Oopsan204/AML_Micromouse_24_2/AML_MicromousePCB/production/bom.xlsx

Sheet: bom
Designator | Footprint | Quantity | Value | LCSC Part # | mã sp linh kiện chất lượngg | ma sp cxt | stt | Quantity | mã sp linh kiện chất lượngg | ma sp cxt
C1, C10, C14, C2, C20, C22, C27, C28, C29, C3, C4, C5, C7, C8, C9 | 603 | 15 | 100nF |  | CLA4098 |  | 1 | 15 | CLA4098
C11 | 603 | 1 | 1uF |  | CLA4103 |  | 2 | 1 | CLA4103
C12, C13 | 603 | 2 | 2.2uF |  | CLA4104 |  | 3 | 2 | CLA4104
C15 | 603 | 1 | 0.1uF |  | CLA4098 |  | 4 | 1 | CLA4098
C16, C17 | 603 | 2 | 15pF |  | CLA4082 |  | 5 | 2 | CLA4082
C18 | 603 | 1 | 22uF |  | CLA4082 |  | 6 | 1 | CLA4082
C19 | 603 | 1 | 10uF |  | CLA4107 |  | 7 | 1 | CLA4107
C21 | 805 | 1 | 150pF |  | CLA4087 |  | 8 | 1 | CLA4087
C23, C24, C30, C31 | CP_EIA-3216-10_Kemet-I | 4 | 22uF |  | CLA1280 |  | 9 | 4 | CLA1280
C25, C26, C32 | CP_EIA-3216-10_Kemet-I | 3 | 10uF |  | CLA1284 |  | 10 | 3 | CLA1284
C6 | 603 | 1 | 4.7uF |  | CLA4095 |  | 11 | 1 | CLA4095
D1 | D_SMA | 1 | 40V-5A |  |  | A022107 | 12 | 1 |  | A022107
D2, D3, D4, D5, D8, D9 | 603 | 1 | LED |  | CL07448 |  | 13 | 1 | CL07448
I2C, J1, ST-LINK | JST 4 | 3 | Conn_01x04_Socket |  | CLA1870(cái)-CLA1880(đực) |  | 14 | 3 | CLA1870(cái)-CLA1880(đực)
J12 | jst | 1 | Conn_01x02_Socket |  | CLA1878(đực),CLA1868(cái) |  | 15 | 1 | CLA1878(đực),CLA1868(cái)
J5 | PinHeader_1x07_P2.54mm_Vertical | 1 | Conn_01x07_Pin |  | CLA1873(cái),CLA1883(đực) |  | 16 | 1 | CLA1873(cái),CLA1883(đực)
L1 | L_7.3x7.3_H4.5 | 1 | 22uH |  | CLA1397 |  | 17 | 1 | CLA1397
LS1 | CUI_CMT-8530S-SMT | 1 | CMT-8530S-SMT |  |  | A081005 | 18 | 5 |  | A081005
MOTER-R, MOTOR-L | JST 6 | 2 | Conn_01x06_Pin |  | CLA1872(cái),CLA1882(đực) |  | 19 | 2 | CLA1872(cái),CLA1882(đực)
Q1 | SOT-23 | 1 | S8550 |  | CL00852(đã có) |  | 20 | 2 dây | CL00852
R1, R2, R3 | 603 | 3 | 10K |  | CLA0759 |  | 21 | 3 | CLA0759
R10, R11, R19, R20 | 603 | 4 | 1K |  | CLA0742 |  | 22 | 4 | CLA0742
R17, R18 | 603 | 2 | 4.7k |  | CL05810 |  | 23 | 2 | CL05810
R21 | 805 | 1 | 1.1R |  | CLA3613 |  | 24 | 1 | CLA3613
R4 | 603 | 1 | 210K |  |  | G080201 | 25 | 1 |  | G080201
R5 | 805 | 1 | 40.2K |  |  | 04Z3XP | 26 | 1 |  | 04Z3XP
R6, R7 | 603 | 2 | 100k |  | CLA0771 |  | 27 | 2 | CLA0771
R8 | 805 | 1 | 75k |  | CLA3340 |  | 28 | 1 | CLA3340
R9 | 805 | 1 | 20k |  | CLA3326 |  | 29 | 1 | CLA3326
RESET, SW2, SW3 | SW_Tactile_SPST_NO_Straight_CK_PTS636Sx25SMTRLFS | 3 | SW_Push |  | CLA1752 |  | 30 | 3 | CLA1752
RN2, RN3 | R_Array_Convex_5x0603 | 2 | R_Pack05 |  | CL08484 |  | 31 | 2 | CL08484
SW4 | SW_DIP_SPSTx05_Slide_KingTek_DSHP05TS_W7.62mm_P1.27mm | 1 | SW_DIP_x05 |  |  | A022606 | 32 | 1 |  | A022606
U1 | LQFP-100_14x14mm_P0.5mm | 1 | STM32H743VITx |  |  |  | 33 | 1
U2 | SOT-223-3_TabPin2 | 1 | AMS1117 |  | CL00249 |  | 34 | 1 | CL00249
U3 | SOP65P760X160-24N | 1 | TB6612FNG_C_8_EL |  |  |  | 35 | 1
U4 | SO-08POWER | 1 | MP1584 |  |  | A081105 | 36 | 1 |  | A081105
U5 | SOT-223-3_TabPin2 | 1 | AMS1117-5.0 |  | CL00250 |  | 37 | 1 | CL00250
Y1 | Crystal_SMD_3225-4Pin_3.2x2.5mm | 1 | Crystal_GND23_Small |  |  |  | 38 | 1
 |  | 5(dây) |  |  | CLA1877 |  | 39 | 5(dây) | CLA1877

Sheet: lên đơn
stt | sll | đơn vị | Quantity | mã sp linh kiện chất lượngg | ma sp cxt | đon giá | thành giá
1 | 2 | dây | 15 | CLA4098 |  | 2000 | 4000
2 | 1 | dây | 1 | CLA4103 |  | 3000 | 3000
3 | 1 | dây | 2 | CLA4104 |  | 4000 | 4000
4 | 1 | dây | 1 | CLA4098 |  | 2000 | 2000
5 | 1 | dây | 2 | CLA4082 |  | 2000 | 2000
6 | 1 | dây | 1 | CLA4082 |  | 2000 | 2000
7 | 1 | dây | 1 | CLA4107 |  | 3000 | 3000
8 | 1 | dây | 1 | CLA4087 |  | 2000 | 2000
9 | 6 | cái | 4 | CLA1280 |  | 2000 | 12000
10 | 5 | cái | 3 | CLA1284 |  | 1400 | 7000
11 | 1 | dây | 1 | CLA4095 |  | 2000 | 2000
12 | 5 | cái | 1 |  | A022107 | 1500 | 7500
13 | 1 | dây | 1 | CL07448 |  | 2500 | 2500
14 | 1 | túi | 3 | CLA1870(cái)-CLA1880(đực) |  | 3000 | 3000 | mỗi thứ 1 túi
15 | 1 | túi | 1 | CLA1878(đực),CLA1868(cái) |  | 2500 | 2500 | mỗi thứ 1 túi
16 | 1 | túi | 1 | CLA1873(cái),CLA1883(đực) |  | 4500 | 4500 | mỗi thứ 1 túi
17 | 4 | cái | 1 | CLA1397 |  | 1500 | 6000
18 | 5 | cái | 1 |  | A081005 | 6000 | 30000
19 | 1 | túi | 2 | CLA1872(cái),CLA1882(đực) |  | 4500 | 4500 | mỗi thứ 1 túi
20 | 1 | dây | 2 | CL00852 |  | 12000 | 12000
21 | 1 | dây | 3 | CLA0759 |  | 2000 | 2000
22 | 1 | dây | 4 | CLA0742 |  | 2000 | 2000
23 | 1 | dây | 2 | CL05810 |  | 2000 | 2000
24 | 1 | dây | 1 | CLA3613 |  | 3000 | 3000
25 | 1 | dây | 1 |  | G080201 | 1800 | 1800
26 | 1 | dây | 1 |  | 04Z3XP | 2300 | 2300
27 | 1 | dây | 2 | CLA0771 |  | 2000 | 2000
28 | 1 | dây | 1 | CLA3340 |  | 3000 | 3000
29 | 1 | dây | 1 | CLA3326 |  | 3000 | 3000
30 | 1 | dây | 3 | CLA1752 |  | 5000 | 5000
31 | 1 | dây | 2 | CL08484 |  | 4000 | 4000
32 | 1 | cái | 1 |  | A022606 | 7000 | 7000
33 | 1 | dây | 1 |  |  |  | 0
34 | 5 | cái | 1 | CL00249 |  | 1400 | 7000
35 | 3 | cái | 1 |  | A051011 | 30000 | 90000
36 | 2 | cái | 1 |  | A081105 | 10500 | 21000
37 | 5 | cái | 1 | CL00250 |  | 1400 | 7000
38 | 1 | dây | 1 |  |  |  | 0
39 | 3 | dây |  | CLA1877 |  | 1000 | 3000
40 | 2 | cái |  |  | G020804 | 3000 | 6000
41 | 1 | cái |  | CLA2435 |  | 1800 | 1800
 |  |  |  |  |  |  | 0
 |  |  |  |  |  |  | 0
 |  |  |  |  |  |  | 0
 |  |  |  |  |  |  | 0
 |  |  |  |  |  |  | 0
 |  |  |  |  |  |  | 288400
