Oopsan204/AML_Micromouse_24_2/thiet_ke/pcb/schematic.step.SLDASM

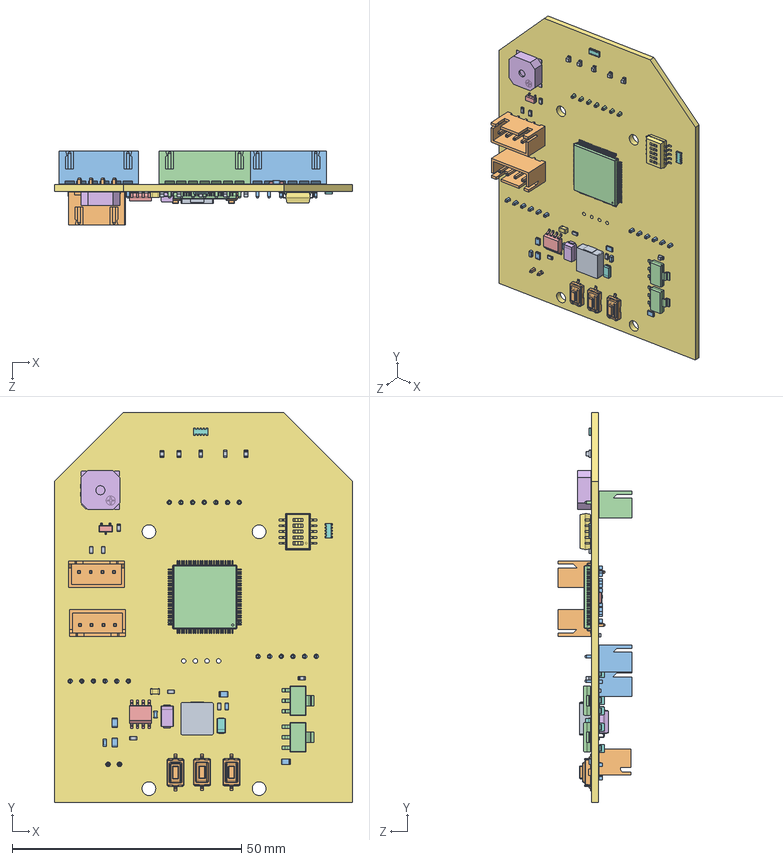
[picture p1: CAD file, 2024-11-29]
thiet_ke/pcb/schematic.step.SLDASM
65.0 x 85.0 x 16.1 mm
LED_0603_1608Metric-0.step x 6
PTS636Sx25SMTRLFS.step x 3
C_0603_1608Metric-1.step x 24
LQFP_100_14x14mm_P05mm.step
SOT_23.step
D_SMA-2.step
C_0805_2012Metric-3.step
R_Array_Convex_5x0603-4.step x 2
R_0603_1608Metric-5.step x 12
JST - XH - Thru - 4Pin - 2.54mm.step x 2
R_0805_2012Metric-6.step x 4
SOT_223.step x 2
ASSEMBLY.step
GSC8530YA-16R2700-7.step
SW_DIP_SPSTx05_Slide_KingTek_DSHP05TS_W762mm_P127mm.step
CP_EIA_3216_10_Kemet_I.step x 7
Inductor_7x7x2.5-8.step
B2B-XH-A(LF)(SN).step
JST - XH - Thru - 6Pin - 2.54mm.step x 2
JST - XH - Thru - 7Pin - 2.54mm.step
Crystal_SMD_3225-4Pin_3.2x2.5mm-9.step
SSOP_24_53x82mm_P065mm.step
schematic_PCB.step
