Oopsan204/AML_Micromouse_24_2/thiet_ke/banh xe 36T.SLDASM

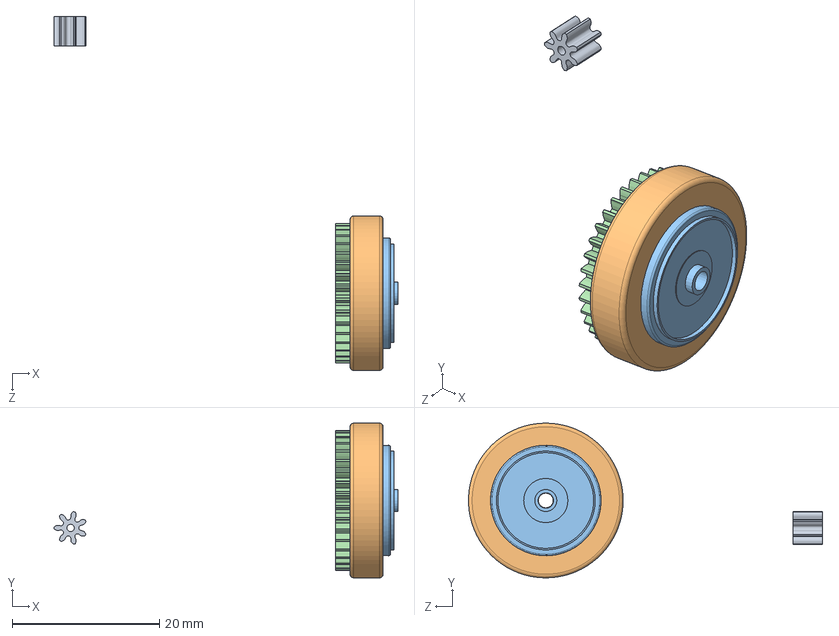
[picture p2: CAD file, 2024-11-29]
thiet_ke/banh xe 36T.SLDASM
46.7 x 21.0 x 48.0 mm
Lop banh xe
Mam banh xe
banh rang 36T truc 2 m0.5.step
banh rang 7T truc1 m0.5
