Oopsan204/AML_Micromouse_24_2/thiet_ke/cumbanh1.SLDASM

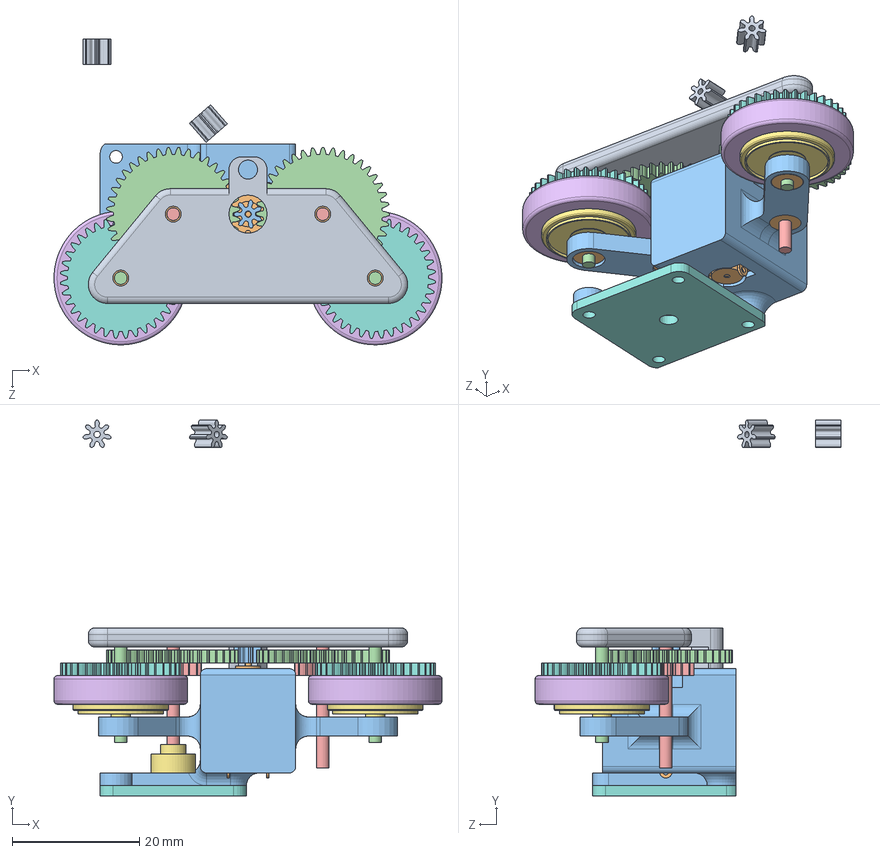
[picture p3: CAD file, 2024-11-29]
thiet_ke/cumbanh1.SLDASM
61.0 x 59.1 x 48.1 mm
N20 DC MOTOR
banh rang 7T truc1 m0.5 x 3
banh rang 40T truc 2 m0.5.step x 2
banh rang 16T truc 2 m0.5.step x 2
Lop banh xe x 2
Mam banh xe x 2
banh rang 36T truc 2 m0.5.step x 2
gangoai
vong bi 2mm x 8
gatrong
truc 2mm 14mm x 2
TRUC 2MM x 2
namcham-encoder
pheutruc
encoder
