Oopsan204/AML_Micromouse_24_2/thiet_ke/cumbanh2.SLDASM

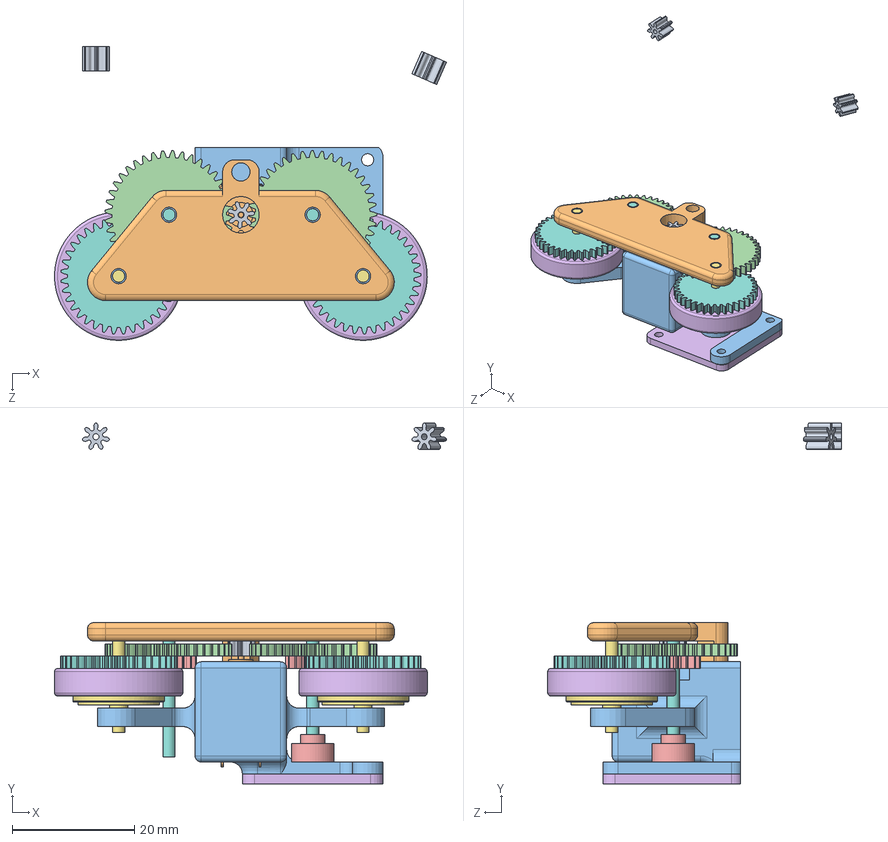
[picture p4: CAD file, 2024-11-29]
thiet_ke/cumbanh2.SLDASM
64.1 x 59.1 x 48.0 mm
N20 DC MOTOR
ga trong 1
banh rang 40T truc 2 m0.5.step x 2
banh rang 16T truc 2 m0.5.step x 2
Lop banh xe x 2
Mam banh xe x 2
banh rang 36T truc 2 m0.5.step x 2
banh rang 7T truc1 m0.5 x 3
gangoai
vong bi 2mm x 8
namcham-encoder
pheutruc
encoder
truc 2mm 14mm x 2
TRUC 2MM x 2
