Oopsan204/AML_Micromouse_24_2/thiet_ke/ver2.5.SLDASM

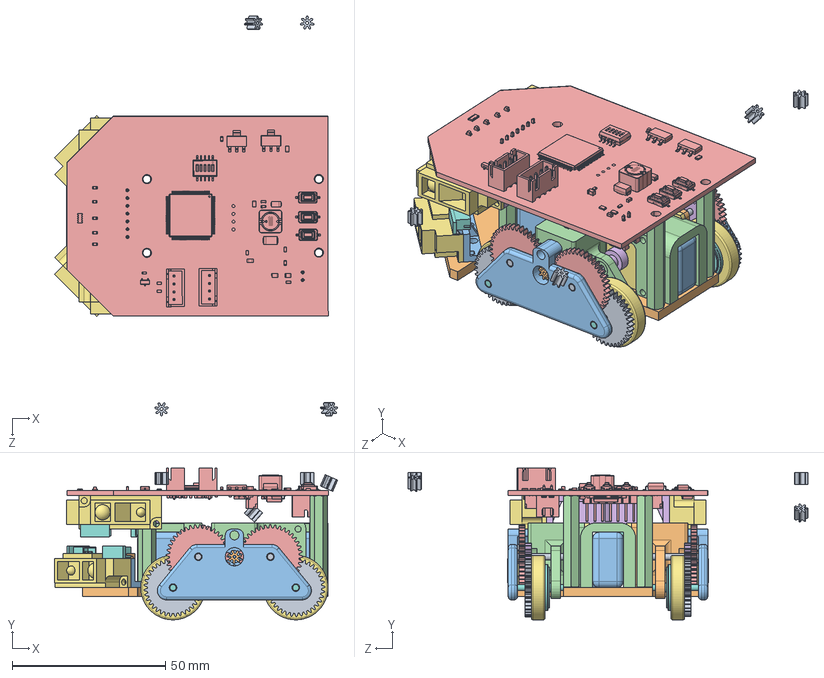
[picture p5: CAD file, 2024-11-29]
thiet_ke/ver2.5.SLDASM
92.3 x 49.4 x 130.3 mm
de mica
N20 DC MOTOR x 2
ga trong 1
banh rang 40T truc 2 m0.5.step x 4
banh rang 16T truc 2 m0.5.step x 4
Lop banh xe x 4
Mam banh xe x 4
banh rang 36T truc 2 m0.5.step x 4
banh rang 7T truc1 m0.5 x 6
gangoai x 2
vong bi 2mm x 16
namcham-encoder x 2
pheutruc x 2
encoder x 2
truc 2mm 14mm x 4
TRUC 2MM x 4
gatrong
pin7.4v 2000mAh 30C
gapin2s x 2
ga cam bien 3
шарп крышка.step x 5
шарп плата.step x 5
92000A010_Passivated 18-8 Stainless Steel Pan Head Phillips Screws.step x 10
ga cam bien don
ga cam bien don trai
truc dong cai cai 30mm x 4
quydo2.step
