Oopsan204/AML_Micromouse_24_2/thiet_ke/banh rang 2 tang 16x40 truc2.SLDASM

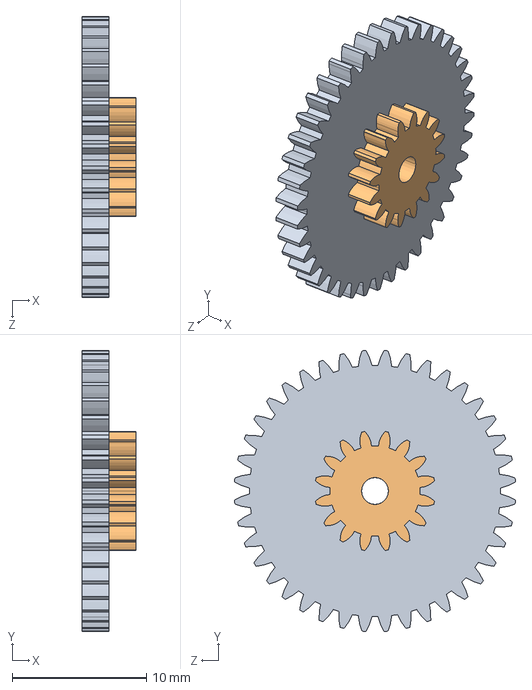
[picture p6: CAD file, 2024-11-29]
thiet_ke/banh rang 2 tang 16x40 truc2.SLDASM
4.00 x 21.0 x 21.0 mm
banh rang 40T truc 2 m0.5.step
banh rang 16T truc 2 m0.5.step
