Oopsan204/AML_Micromouse_24_2/AML_MicromousePCB/3d_modol/GSC8530YA-16R2700.STEP

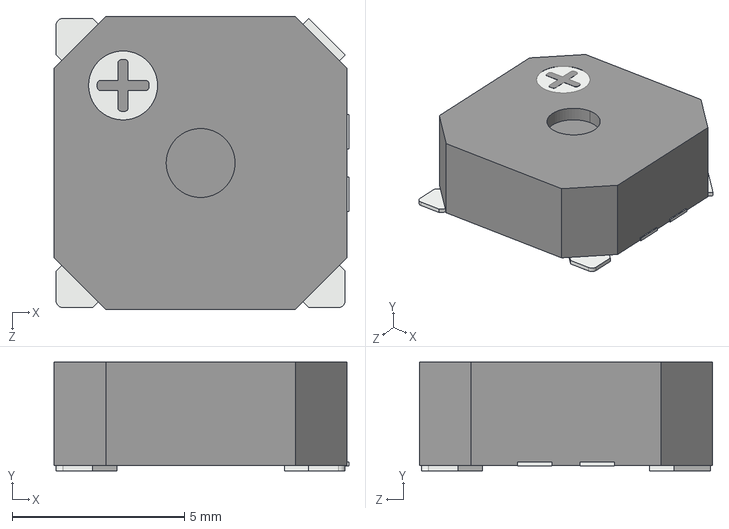
[picture p7: CAD file, 2024-11-29]
AML_MicromousePCB/3d_modol/GSC8530YA-16R2700.STEP
8.55 x 3.15 x 8.50 mm
