Oopsan204/AML_Micromouse_24_2/AML_MicromousePCB/MP1584/MP1584.step

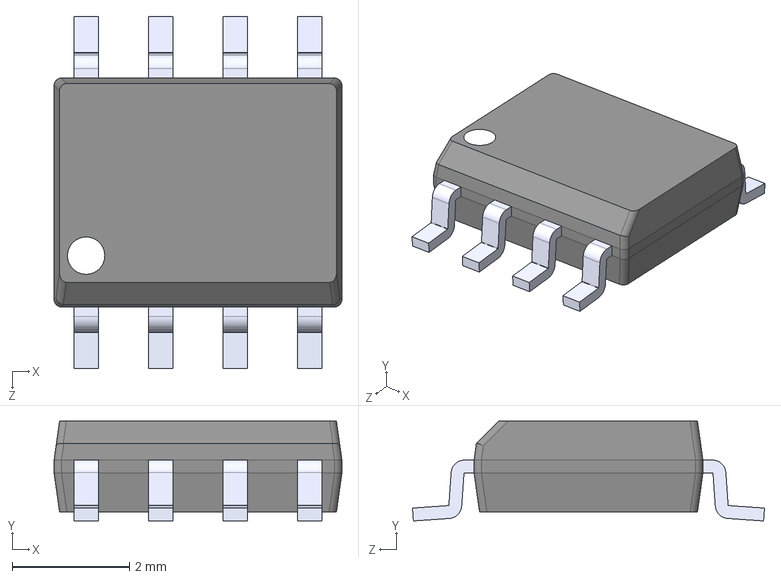
[picture p10: CAD file, 2024-09-05]
AML_MicromousePCB/MP1584/MP1584.step
4.90 x 1.70 x 5.99 mm
