Oopsan204/AML_Micromouse_24_2/AML_MicromousePCB/outline/pcb.DXF

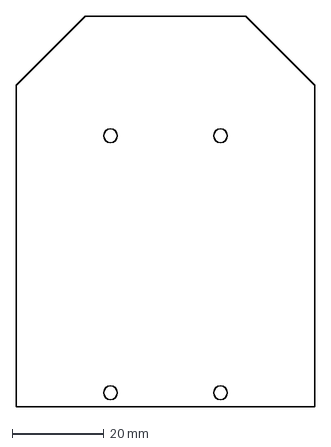
[picture p11: CAD file, 2024-09-10]
AML_MicromousePCB/outline/pcb.DXF
65.0 x 85.0 mm
