Oopsan204/AML_Micromouse_24_2/AML_MicromousePCB/PCB micromouse T2.DXF

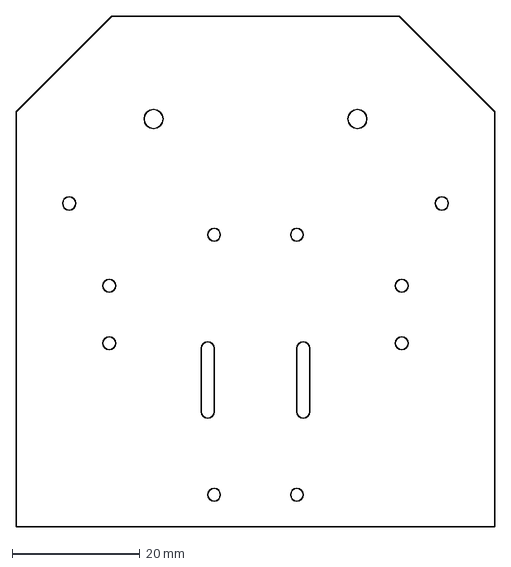
[picture p12: CAD file, 2024-09-10]
AML_MicromousePCB/PCB micromouse T2.DXF
75.0 x 80.0 mm
