Oopsan204/AML_Micromouse_24_2/AML_MicromousePCB/TB6612FNG/TB6612FNG,C,8,EL.STEP

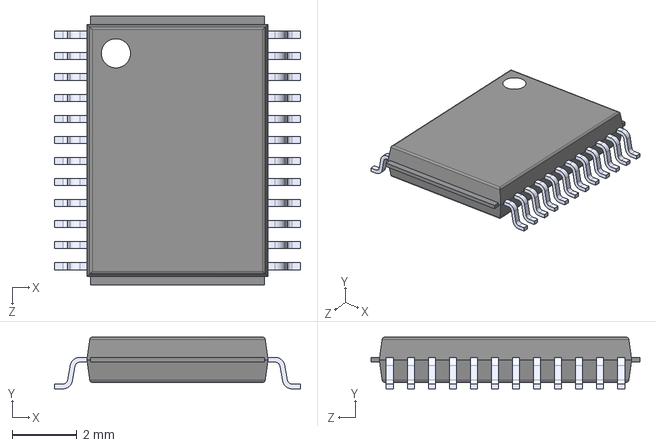
[picture p13: CAD file, 2024-09-05]
AML_MicromousePCB/TB6612FNG/TB6612FNG,C,8,EL.STEP
7.60 x 1.60 x 8.30 mm
