Oopsan204/AML_Micromouse_24_2/thiet_ke/ga cam bien don trai.SLDPRT

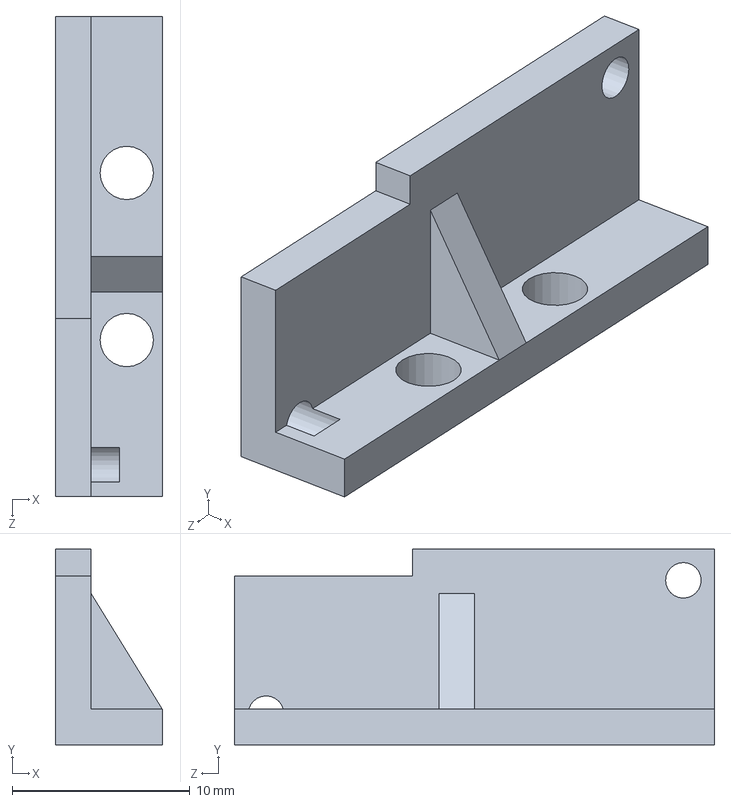
[picture p14: CAD file, 2024-11-29]
thiet_ke/ga cam bien don trai.SLDPRT
6.00 x 11.0 x 27.0 mm
