Oopsan204/AML_Micromouse_24_2/AML_MicromousePCB/3d_modol/INDUCTOR_73x73h5.step

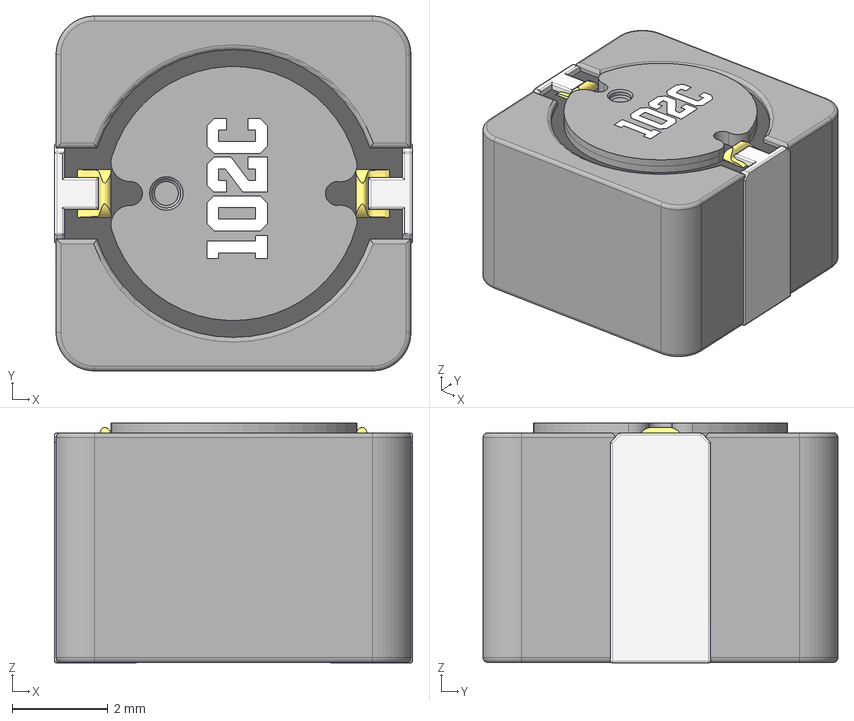
[picture p15: CAD file, 2024-11-29]
AML_MicromousePCB/3d_modol/INDUCTOR_73x73h5.step
7.47 x 7.40 x 5.00 mm
Fill
Pins
Copper
Pins001
Copper001
Text
