Oopsan204/AML_Micromouse_24_2/thiet_ke/banh rang 7T truc1 m0.5.SLDPRT

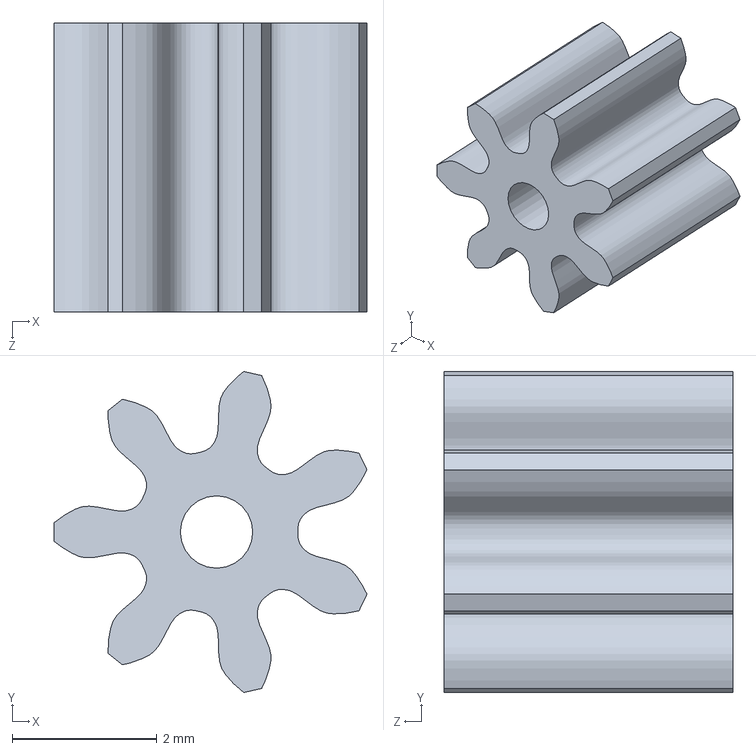
[picture p18: CAD file, 2024-11-29]
thiet_ke/banh rang 7T truc1 m0.5.SLDPRT
4.33 x 4.44 x 4.00 mm
