Oopsan204/AML_Micromouse_24_2/AML_MicromousePCB/3d_modol/Inductor_7x7x2.5.STEP

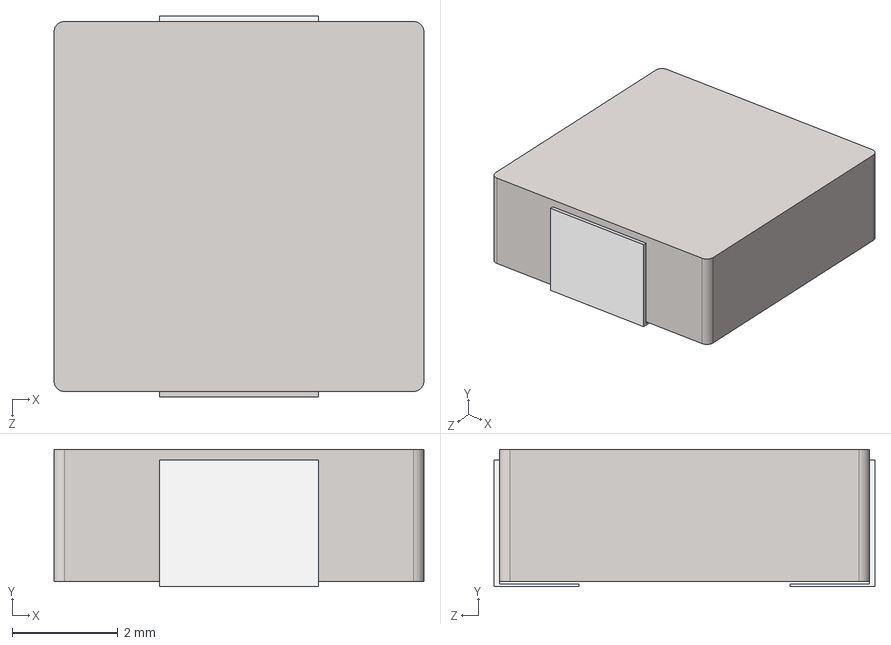
[picture p19: CAD file, 2024-11-29]
AML_MicromousePCB/3d_modol/Inductor_7x7x2.5.STEP
7.00 x 2.60 x 7.20 mm
