Oopsan204/AML_Micromouse_24_2/AML_MicromousePCB/3d_modol/SO-8_narrow_simple.step

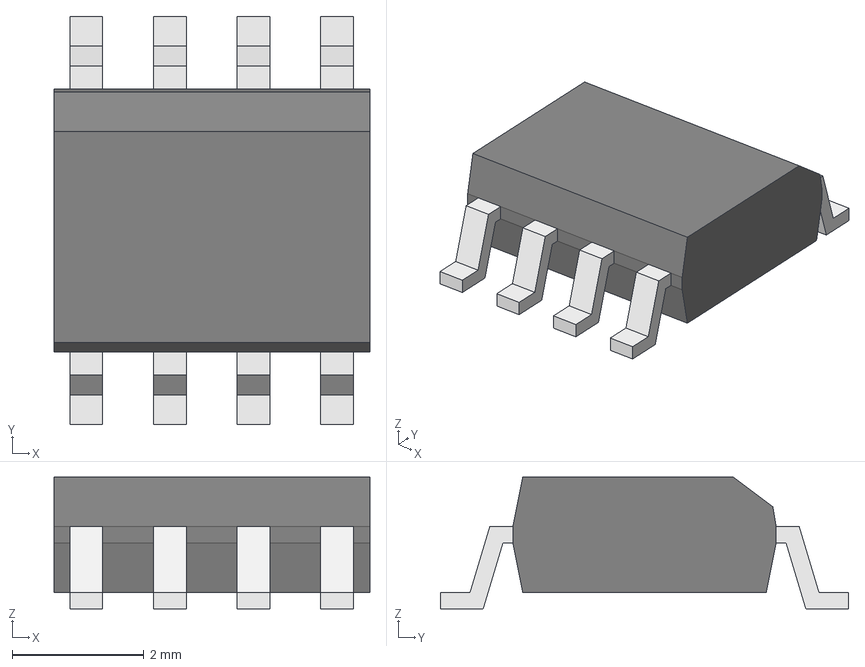
[picture p23: CAD file, 2024-11-29]
AML_MicromousePCB/3d_modol/SO-8_narrow_simple.step
4.80 x 6.20 x 2.00 mm
