Oopsan204/AML_Micromouse_24_2/thiet_ke/N20 DC MOTOR.SLDPRT

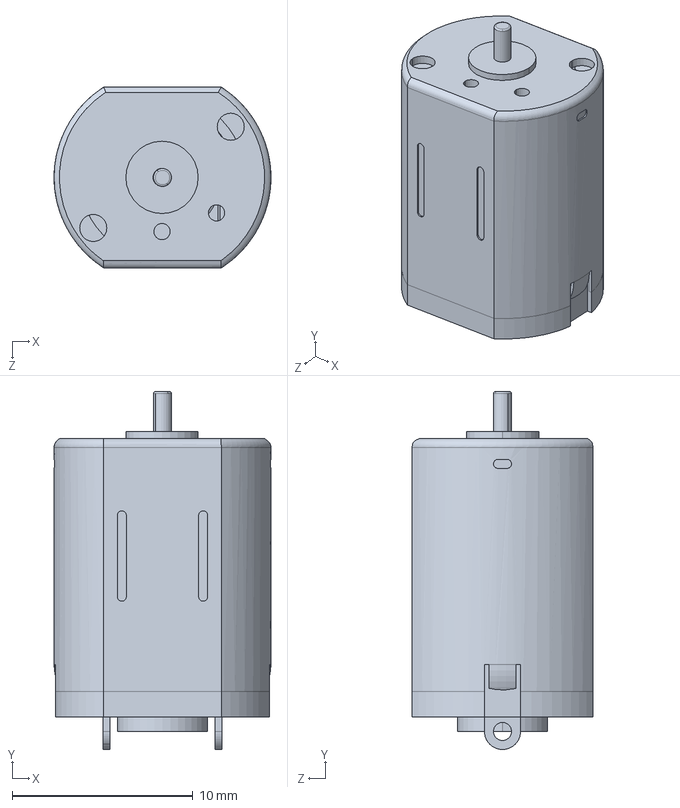
[picture p26: CAD file, 2024-11-29]
thiet_ke/N20 DC MOTOR.SLDPRT
12.0 x 19.8 x 10.0 mm
