Oopsan204/AML_Micromouse_24_2/AML_MicromousePCB/3d_modol/JST - XH - Thru (V) - 7Pin - 2.54mm.stp

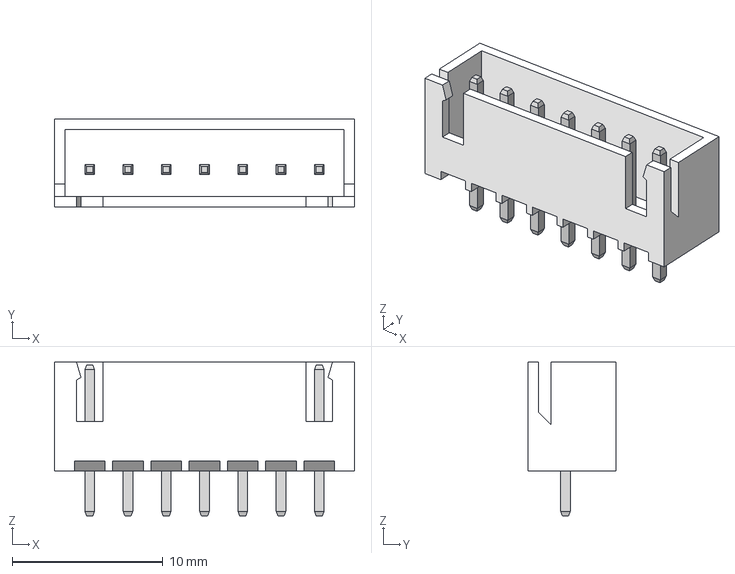
[picture p27: CAD file, 2024-11-29]
AML_MicromousePCB/3d_modol/JST - XH - Thru (V) - 7Pin - 2.54mm.stp
19.9 x 5.84 x 10.2 mm
