Oopsan204/AML_Micromouse_24_2/thiet_ke/gangoai.SLDPRT

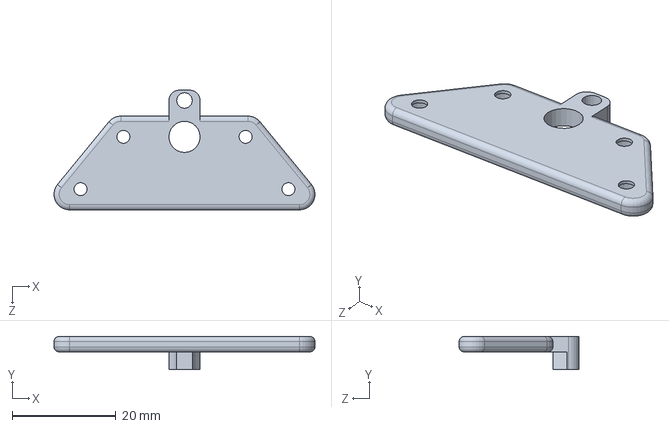
[picture p30: CAD file, 2024-11-29]
thiet_ke/gangoai.SLDPRT
50.2 x 6.40 x 23.0 mm
