Oopsan204/AML_Micromouse_24_2/AML_MicromousePCB/3d_modol/CUI_DEVICES_CMT-8504-100-SMT-TR.step

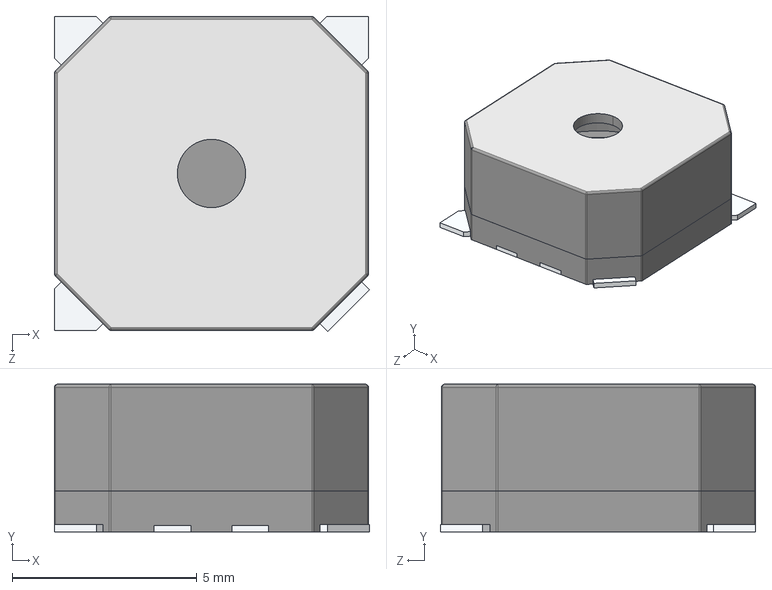
[picture p31: CAD file, 2024-11-29]
AML_MicromousePCB/3d_modol/CUI_DEVICES_CMT-8504-100-SMT-TR.step
8.53 x 4.00 x 8.53 mm
