Oopsan204/AML_Micromouse_24_2/thiet_ke/Mam banh xe.SLDPRT

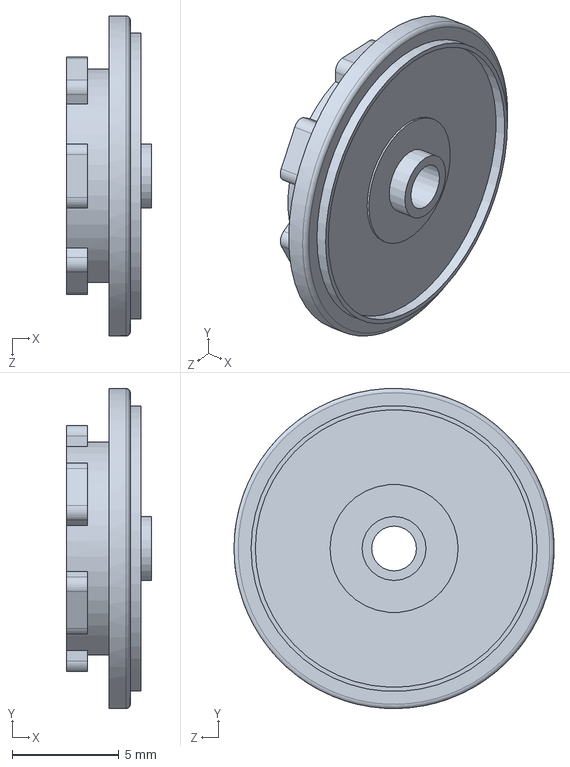
[picture p34: CAD file, 2024-11-29]
thiet_ke/Mam banh xe.SLDPRT
4.00 x 15.0 x 15.0 mm
