Oopsan204/AML_Micromouse_24_2/AML_MicromousePCB/3d_modol/JST - XH - Thru (V) - 4Pin - 2.54mm.stp

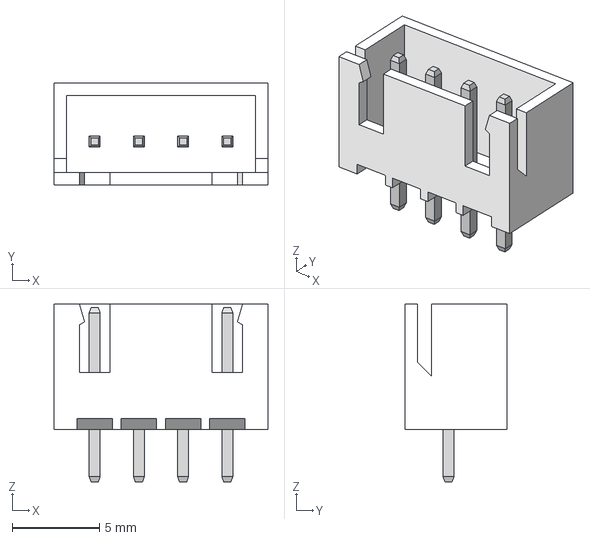
[picture p35: CAD file, 2024-11-29]
AML_MicromousePCB/3d_modol/JST - XH - Thru (V) - 4Pin - 2.54mm.stp
12.3 x 5.84 x 10.2 mm
