Oopsan204/AML_Micromouse_24_2/AML_MicromousePCB/jts_Kicad/Thru Horizontal/JST - XH - Thru (R) - 16Pin - 2.54mm.stp

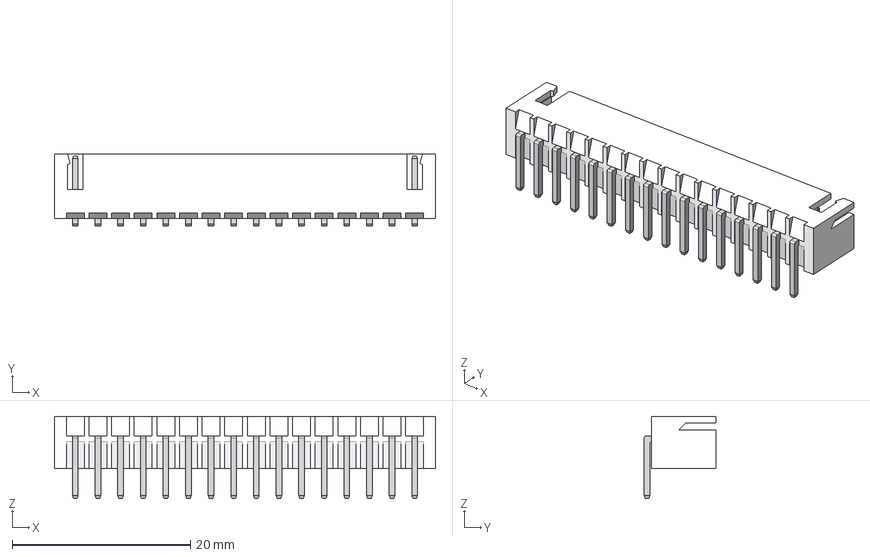
[picture p36: CAD file, 2024-11-29]
AML_MicromousePCB/jts_Kicad/Thru Horizontal/JST - XH - Thru (R) - 16Pin - 2.54mm.stp
42.8 x 8.04 x 9.22 mm
