Oopsan204/AML_Micromouse_24_2/thiet_ke/gatrong.SLDPRT

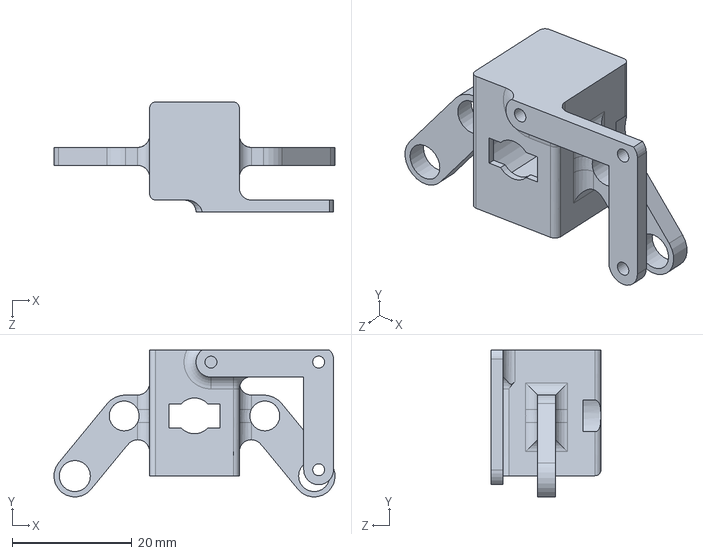
[picture p38: CAD file, 2024-11-29]
thiet_ke/gatrong.SLDPRT
47.0 x 24.5 x 18.4 mm
