Oopsan204/AML_Micromouse_24_2/thiet_ke/namcham-encoder.SLDPRT

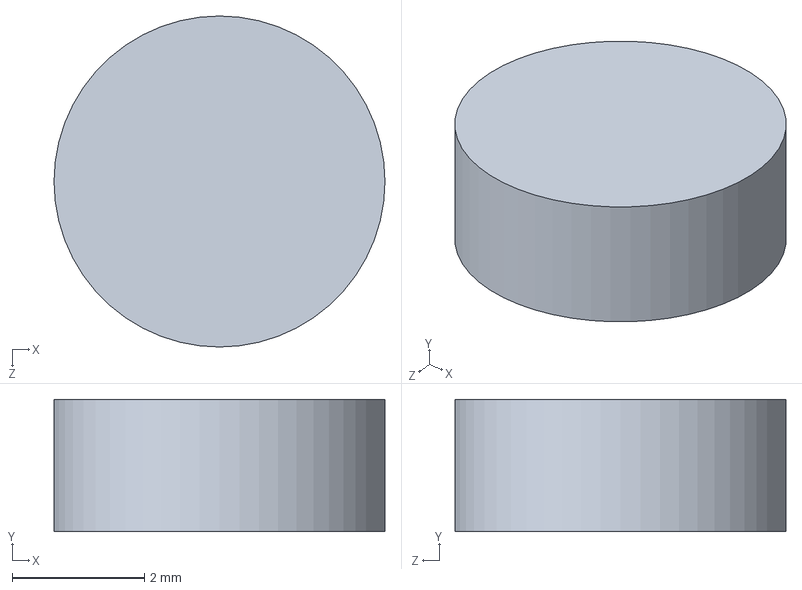
[picture p41: CAD file, 2024-11-29]
thiet_ke/namcham-encoder.SLDPRT
5.00 x 2.00 x 5.00 mm
