Oopsan204/AML_Micromouse_24_2/AML_MicromousePCB/3d_modol/BM06B-SRSS-TB.STEP

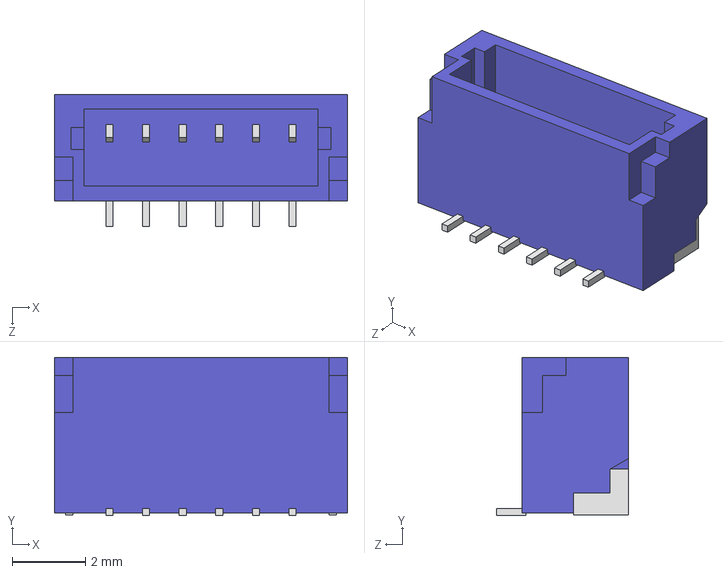
[picture p42: CAD file, 2024-11-29]
AML_MicromousePCB/3d_modol/BM06B-SRSS-TB.STEP
8.00 x 4.32 x 3.60 mm
