Oopsan204/AML_Micromouse_24_2/thiet_ke/Lop banh xe.SLDPRT

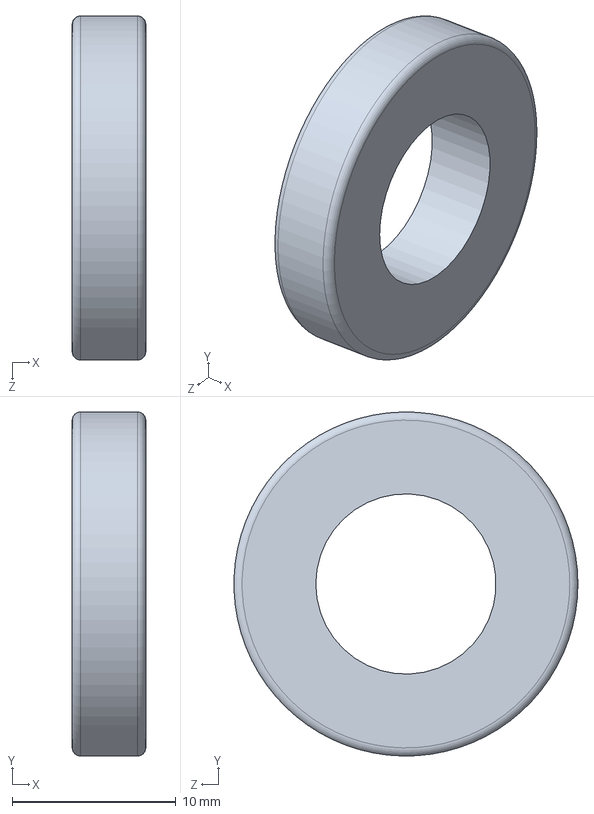
[picture p45: CAD file, 2024-11-29]
thiet_ke/Lop banh xe.SLDPRT
4.50 x 21.0 x 21.0 mm
