Oopsan204/AML_Micromouse_24_2/thiet_ke/de in3d.SLDPRT

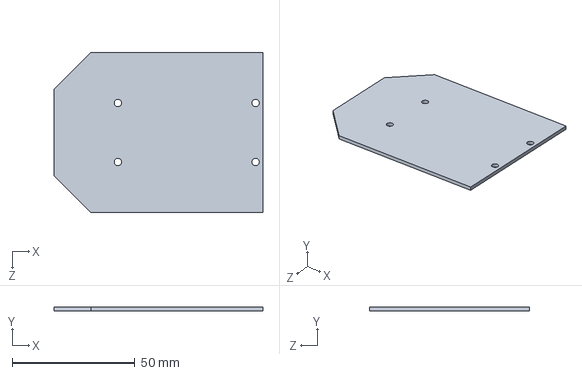
[picture p48: CAD file, 2024-11-29]
thiet_ke/de in3d.SLDPRT
85.0 x 1.60 x 65.0 mm
