Oopsan204/AML_Micromouse_24_2/thiet_ke/banh rang 40T truc 2 m0.5.STEP

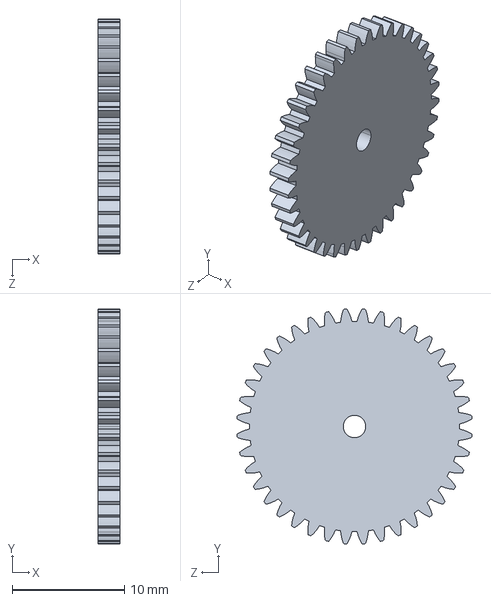
[picture p55: CAD file, 2024-11-29]
thiet_ke/banh rang 40T truc 2 m0.5.STEP
2.00 x 21.0 x 21.0 mm
