Oopsan204/AML_Micromouse_24_2/thiet_ke/truc dong cai cai 30mm.SLDPRT

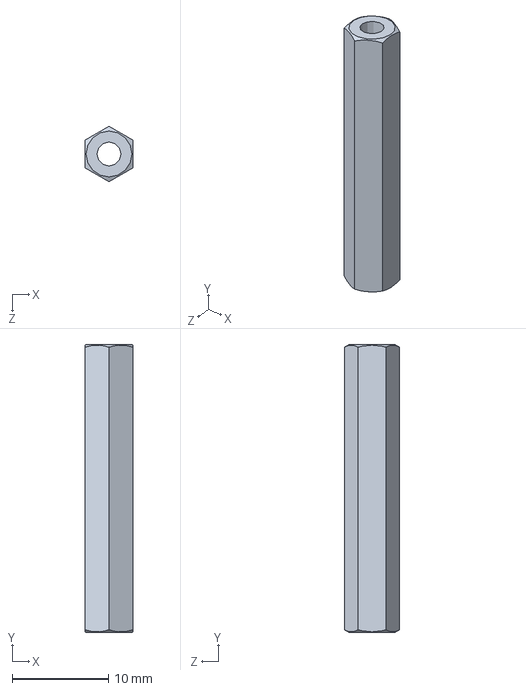
[picture p58: CAD file, 2024-11-29]
thiet_ke/truc dong cai cai 30mm.SLDPRT
5.00 x 30.0 x 5.77 mm
