Oopsan204/AML_Micromouse_24_2/thiet_ke/banh rang 16T truc 2 m0.5.STEP

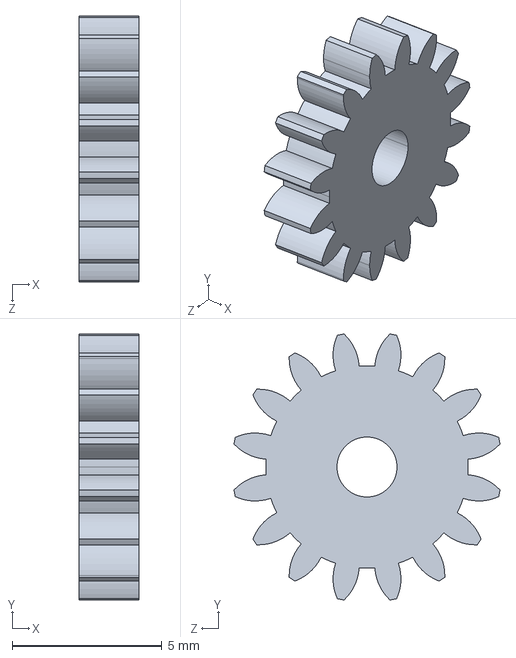
[picture p60: CAD file, 2024-11-29]
thiet_ke/banh rang 16T truc 2 m0.5.STEP
2.00 x 8.87 x 8.87 mm
