Oopsan204/AML_Micromouse_24_2/AML_MicromousePCB/jts_Kicad/Thru Horizontal/JST - XH - Thru (R) - 15Pin - 2.54mm.stp

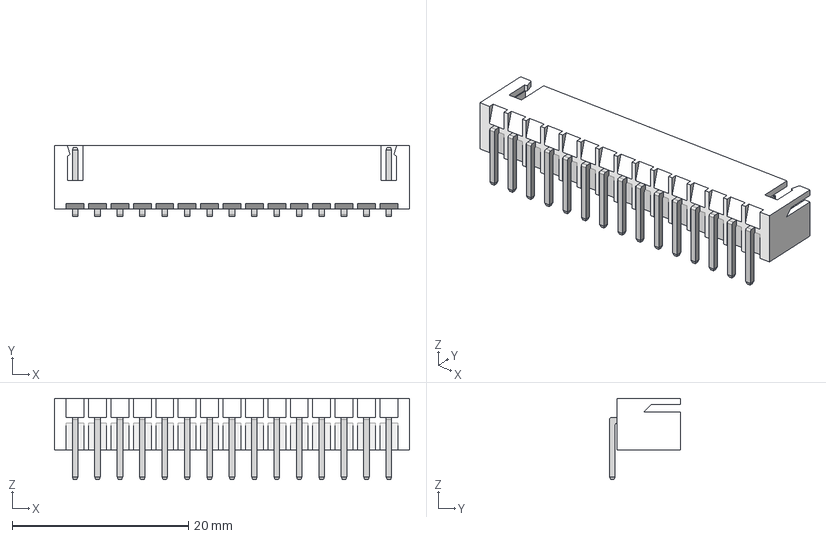
[picture p61: CAD file, 2024-11-29]
AML_MicromousePCB/jts_Kicad/Thru Horizontal/JST - XH - Thru (R) - 15Pin - 2.54mm.stp
40.2 x 8.04 x 9.22 mm
