Oopsan204/AML_Micromouse_24_2/thiet_ke/de mica.SLDPRT

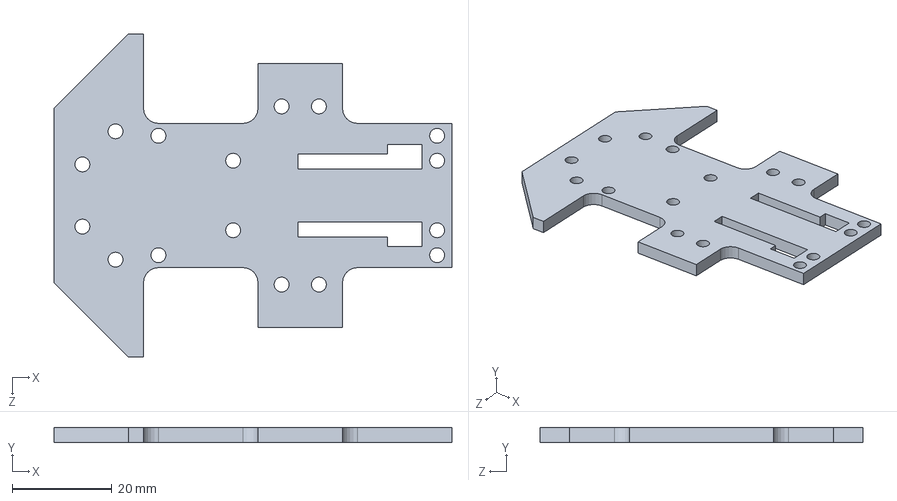
[picture p62: CAD file, 2024-11-29]
thiet_ke/de mica.SLDPRT
80.0 x 3.00 x 65.0 mm
