Oopsan204/AML_Micromouse_24_2/AML_MicromousePCB/jts_Kicad/Thru Vertical/JST - XH - Thru (V) - 15Pin - 2.54mm.stp

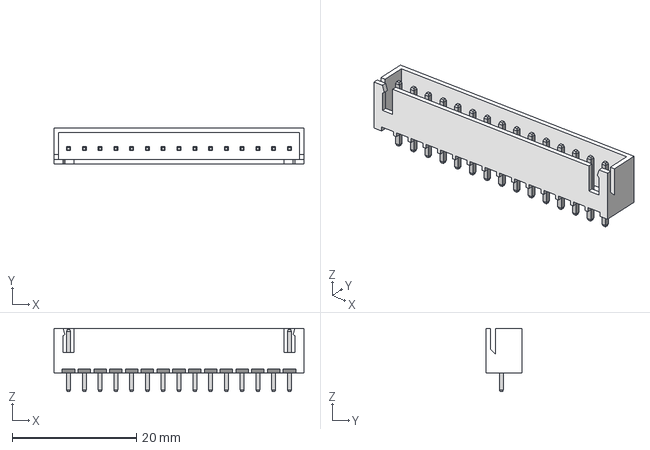
[picture p64: CAD file, 2024-11-29]
AML_MicromousePCB/jts_Kicad/Thru Vertical/JST - XH - Thru (V) - 15Pin - 2.54mm.stp
40.2 x 5.84 x 10.2 mm
