Oopsan204/AML_Micromouse_24_2/thiet_ke/ga cam bien 3.SLDPRT

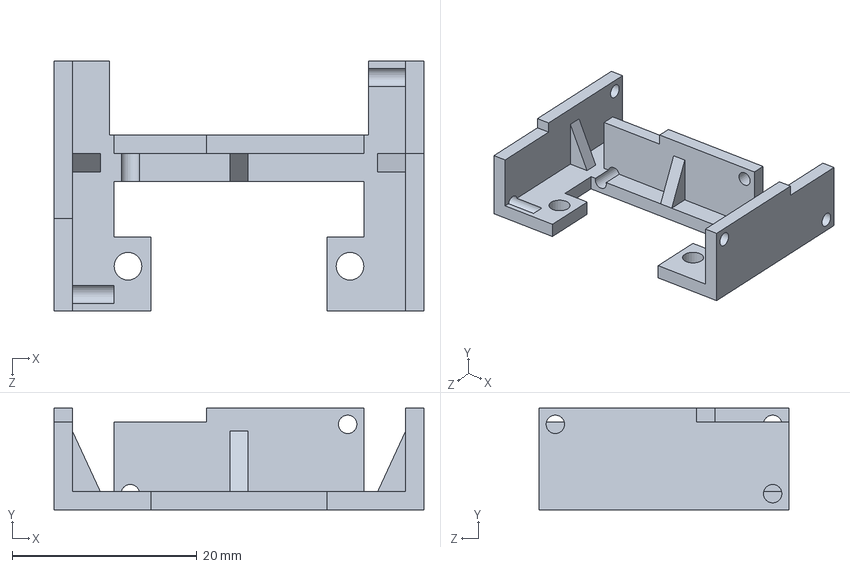
[picture p65: CAD file, 2024-11-29]
thiet_ke/ga cam bien 3.SLDPRT
40.0 x 11.0 x 27.0 mm
