Oopsan204/AML_Micromouse_24_2/AML_MicromousePCB/jts_Kicad/Thru Vertical/JST - XH - Thru (V) - 20Pin - 2.54mm.stp

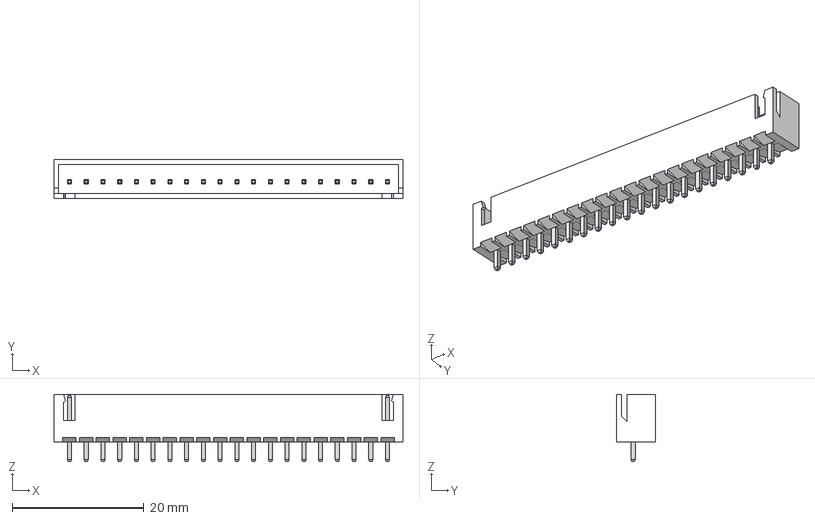
[picture p67: CAD file, 2024-11-29]
AML_MicromousePCB/jts_Kicad/Thru Vertical/JST - XH - Thru (V) - 20Pin - 2.54mm.stp
52.9 x 5.84 x 10.2 mm
