Oopsan204/AML_Micromouse_24_2/thiet_ke/SHARP GP2Y0A51SK0F.step

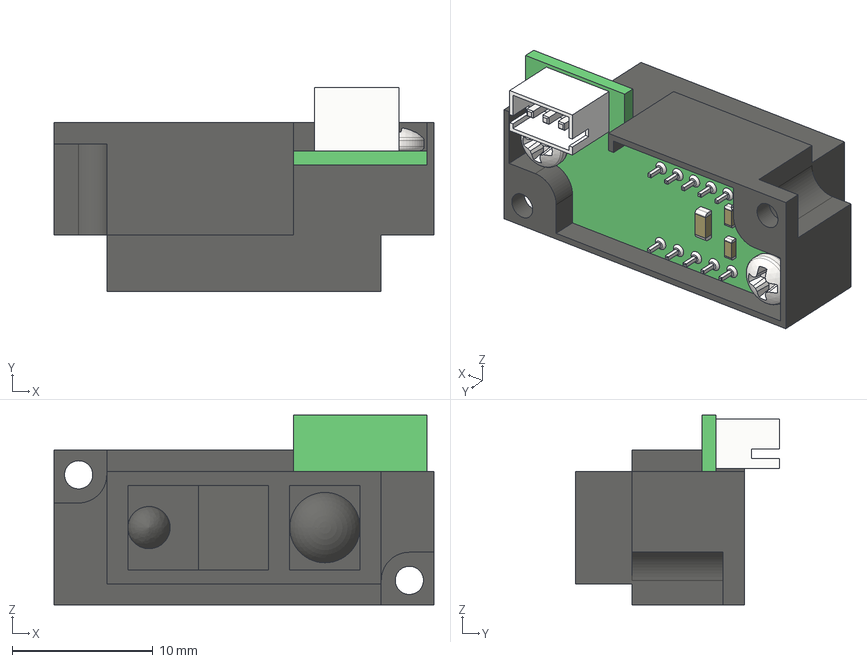
[picture p70: CAD file, 2024-11-29]
thiet_ke/SHARP GP2Y0A51SK0F.step
27.0 x 14.5 x 13.5 mm
шарп крышка
шарп плата
92000A010_Passivated 18-8 Stainless Steel Pan Head Phillips Screws x 2
