Oopsan204/AML_Micromouse_24_2/thiet_ke/encoder.SLDPRT

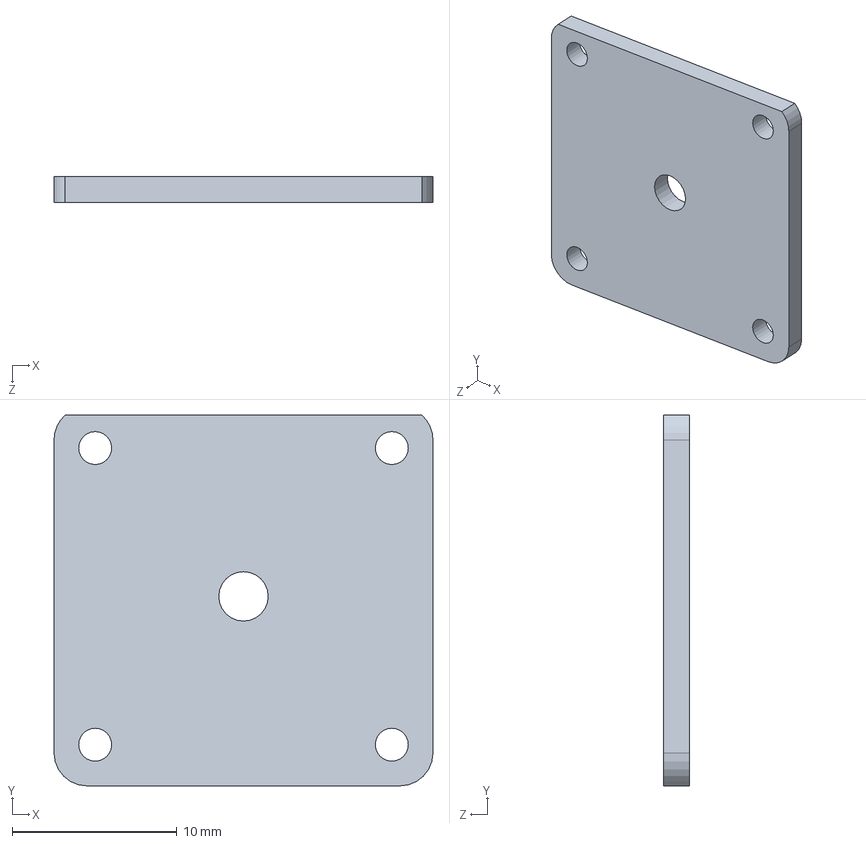
[picture p71: CAD file, 2024-11-29]
thiet_ke/encoder.SLDPRT
23.0 x 22.5 x 1.60 mm
