Oopsan204/AML_Micromouse_24_2/thiet_ke/truc 2mm 14mm.SLDPRT

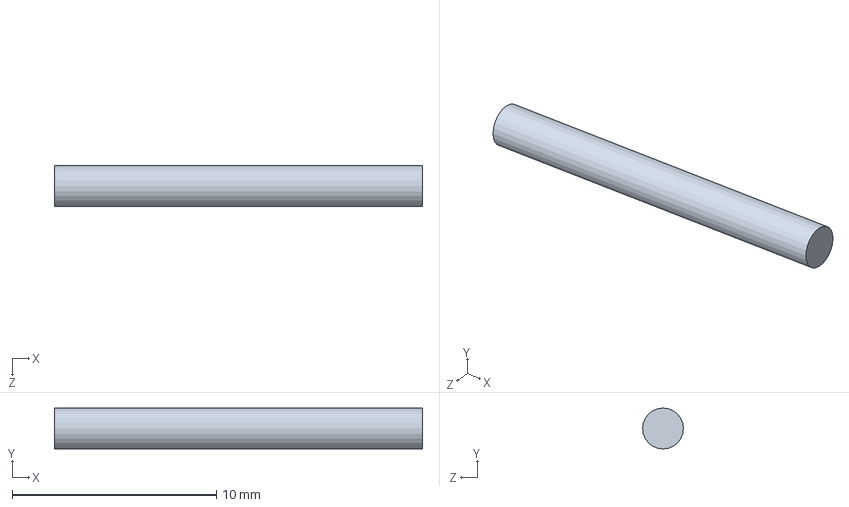
[picture p72: CAD file, 2024-11-29]
thiet_ke/truc 2mm 14mm.SLDPRT
18.0 x 2.00 x 2.00 mm
