Oopsan204/AML_Micromouse_24_2/thiet_ke/vong bi 2mm.SLDPRT

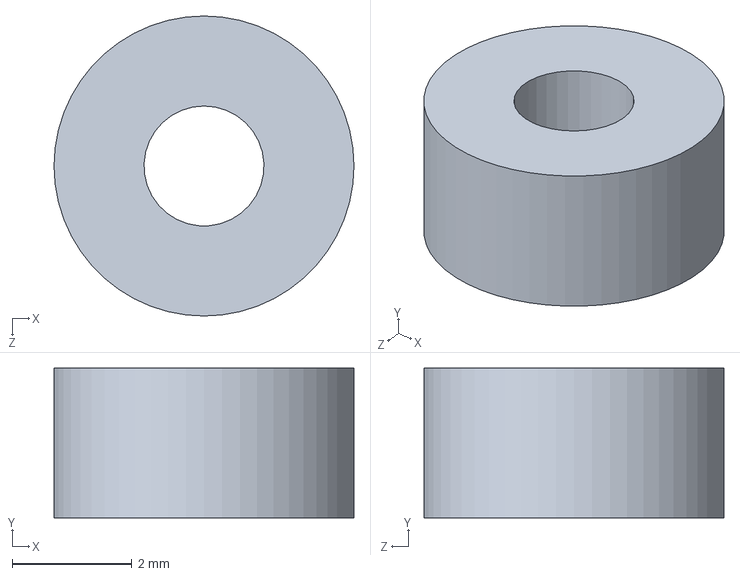
[picture p73: CAD file, 2024-11-29]
thiet_ke/vong bi 2mm.SLDPRT
5.00 x 2.50 x 5.00 mm
