Oopsan204/AML_Micromouse_24_2/thiet_ke/banh rang 36T truc 2 m0.5.STEP

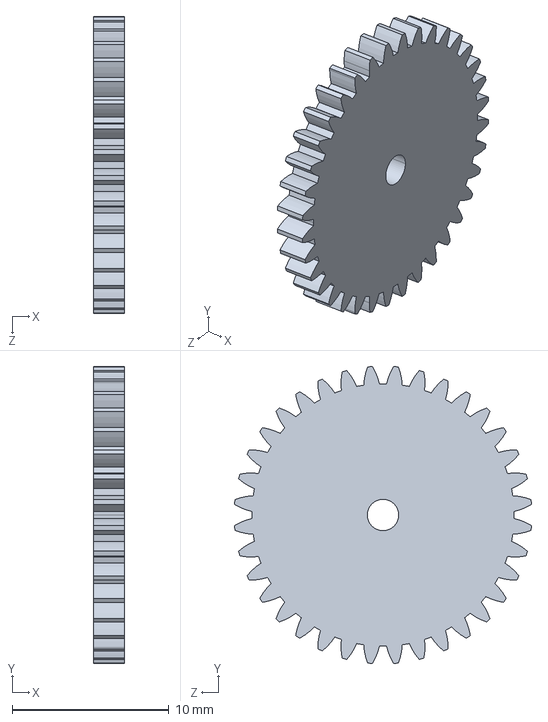
[picture p74: CAD file, 2024-11-29]
thiet_ke/banh rang 36T truc 2 m0.5.STEP
2.00 x 19.0 x 19.0 mm
