Oopsan204/AML_Micromouse_24_2/thiet_ke/pin7.4v 2000mAh 30C.SLDPRT

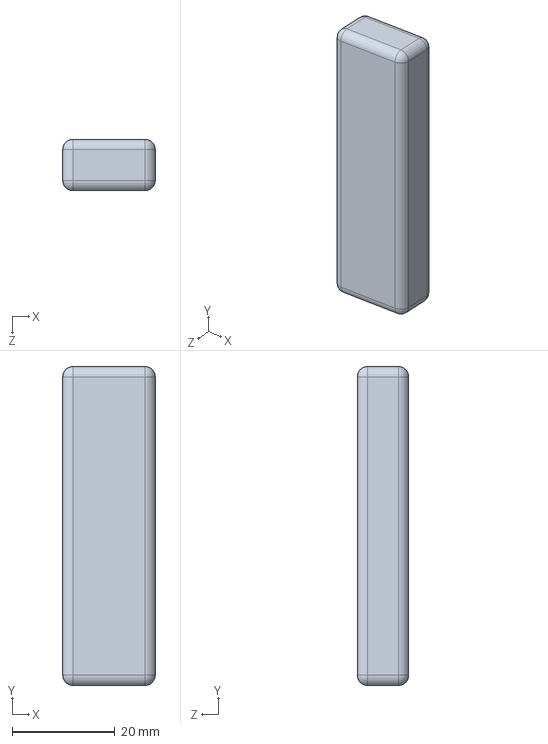
[picture p75: CAD file, 2024-11-29]
thiet_ke/pin7.4v 2000mAh 30C.SLDPRT
18.0 x 62.0 x 10.0 mm
