Oopsan204/AML_Micromouse_24_2/thiet_ke/pheutruc.SLDPRT

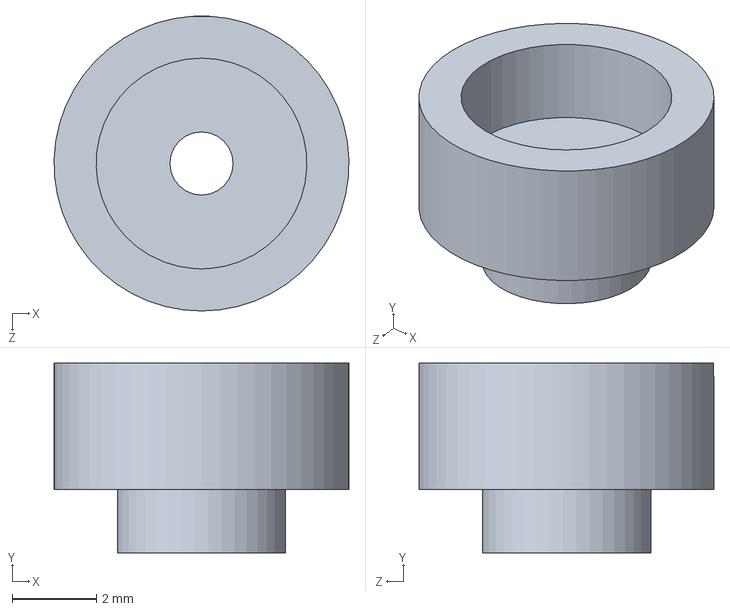
[picture p76: CAD file, 2024-11-29]
thiet_ke/pheutruc.SLDPRT
7.00 x 4.50 x 7.00 mm
