Oopsan204/AML_Micromouse_24_2/thiet_ke/TRUC 2MM.SLDPRT

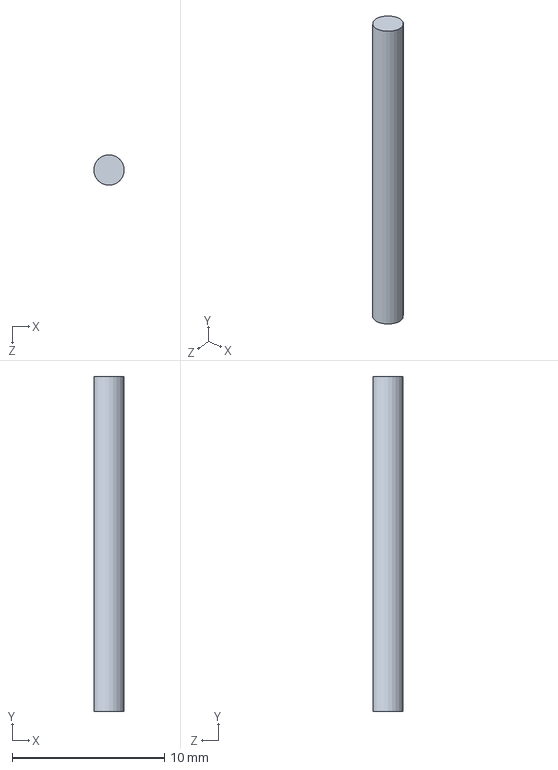
[picture p77: CAD file, 2024-11-29]
thiet_ke/TRUC 2MM.SLDPRT
2.00 x 22.0 x 2.00 mm
