Oopsan204/AML_Micromouse_24_2/thiet_ke/gapin2s.SLDPRT

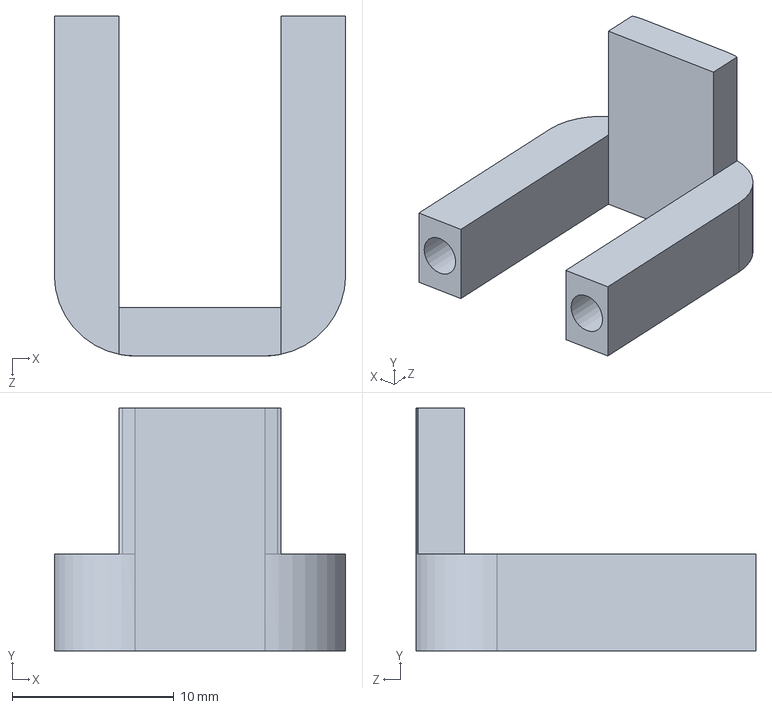
[picture p78: CAD file, 2024-11-29]
thiet_ke/gapin2s.SLDPRT
18.0 x 15.0 x 21.0 mm
