Oopsan204/AML_Micromouse_24_2/(list of files, cad)

Other CAD files:
thiet_ke/ga trong 1.SLDPRT
thiet_ke/22082024 micromouse T2.SLDASM
