Oopsan204/AML_Micromouse_24_2/AML_MicromousePCB/schematic.pdf

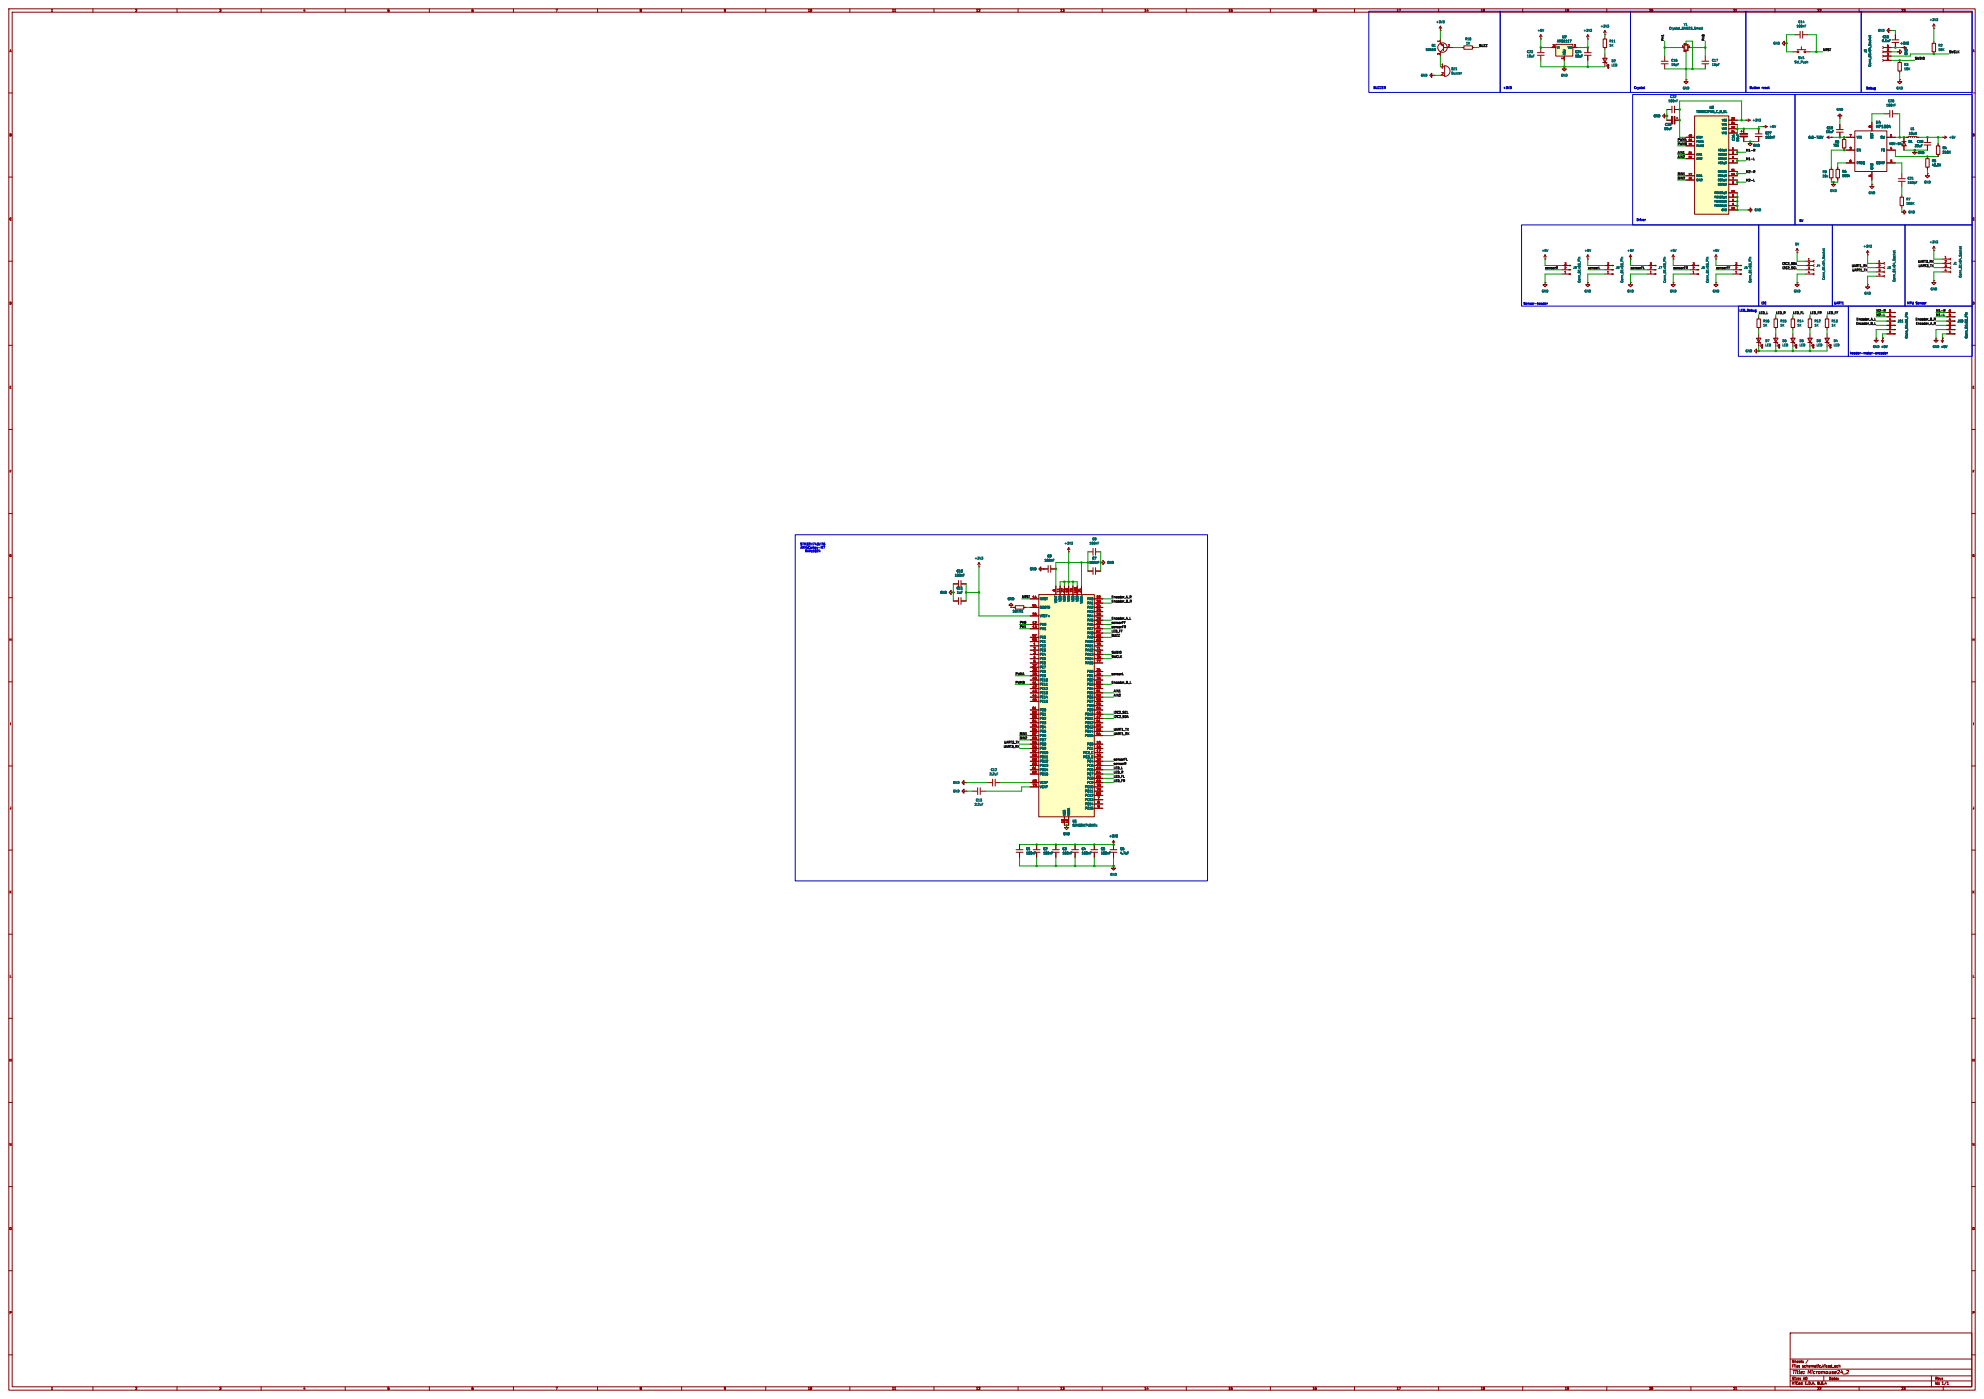
[picture p81: page 1]
