Oopsan204/AML_Micromouse_24_2/(list of files, drawings)

Other design files:
AML_MicromousePCB/freerouting.dsn
AML_MicromousePCB/schematic.dsn
AML_MicromousePCB/temp-freerouting.dsn
