Oopsan204/AML_Micromouse_24_2/AML_MicromousePCB/schematic.kicad_pcb

## KiCad design AML_MicromousePCB/schematic.kicad_pcb (2024-11-29)

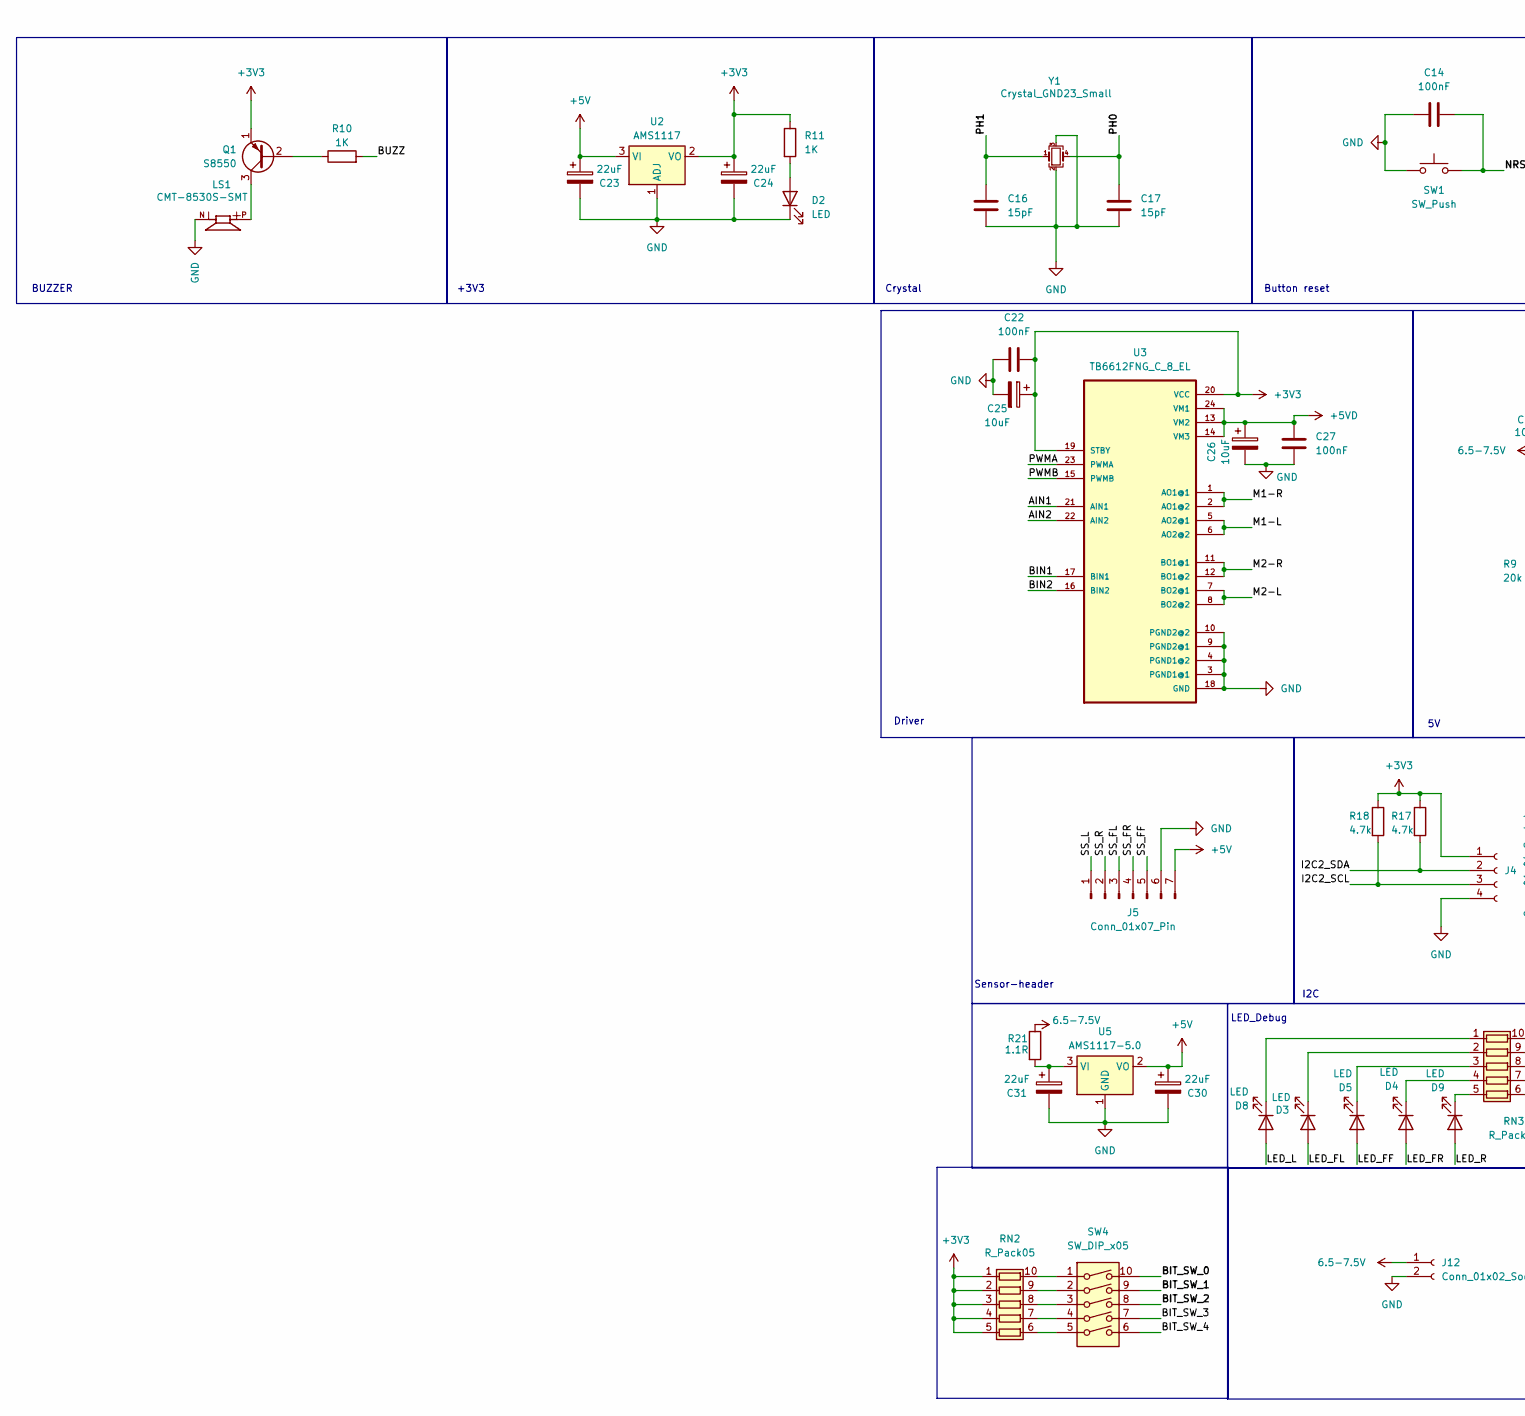
[picture p82: schematic schematic.kicad_sch, Micromouse24_2, part in row 1, column 1]

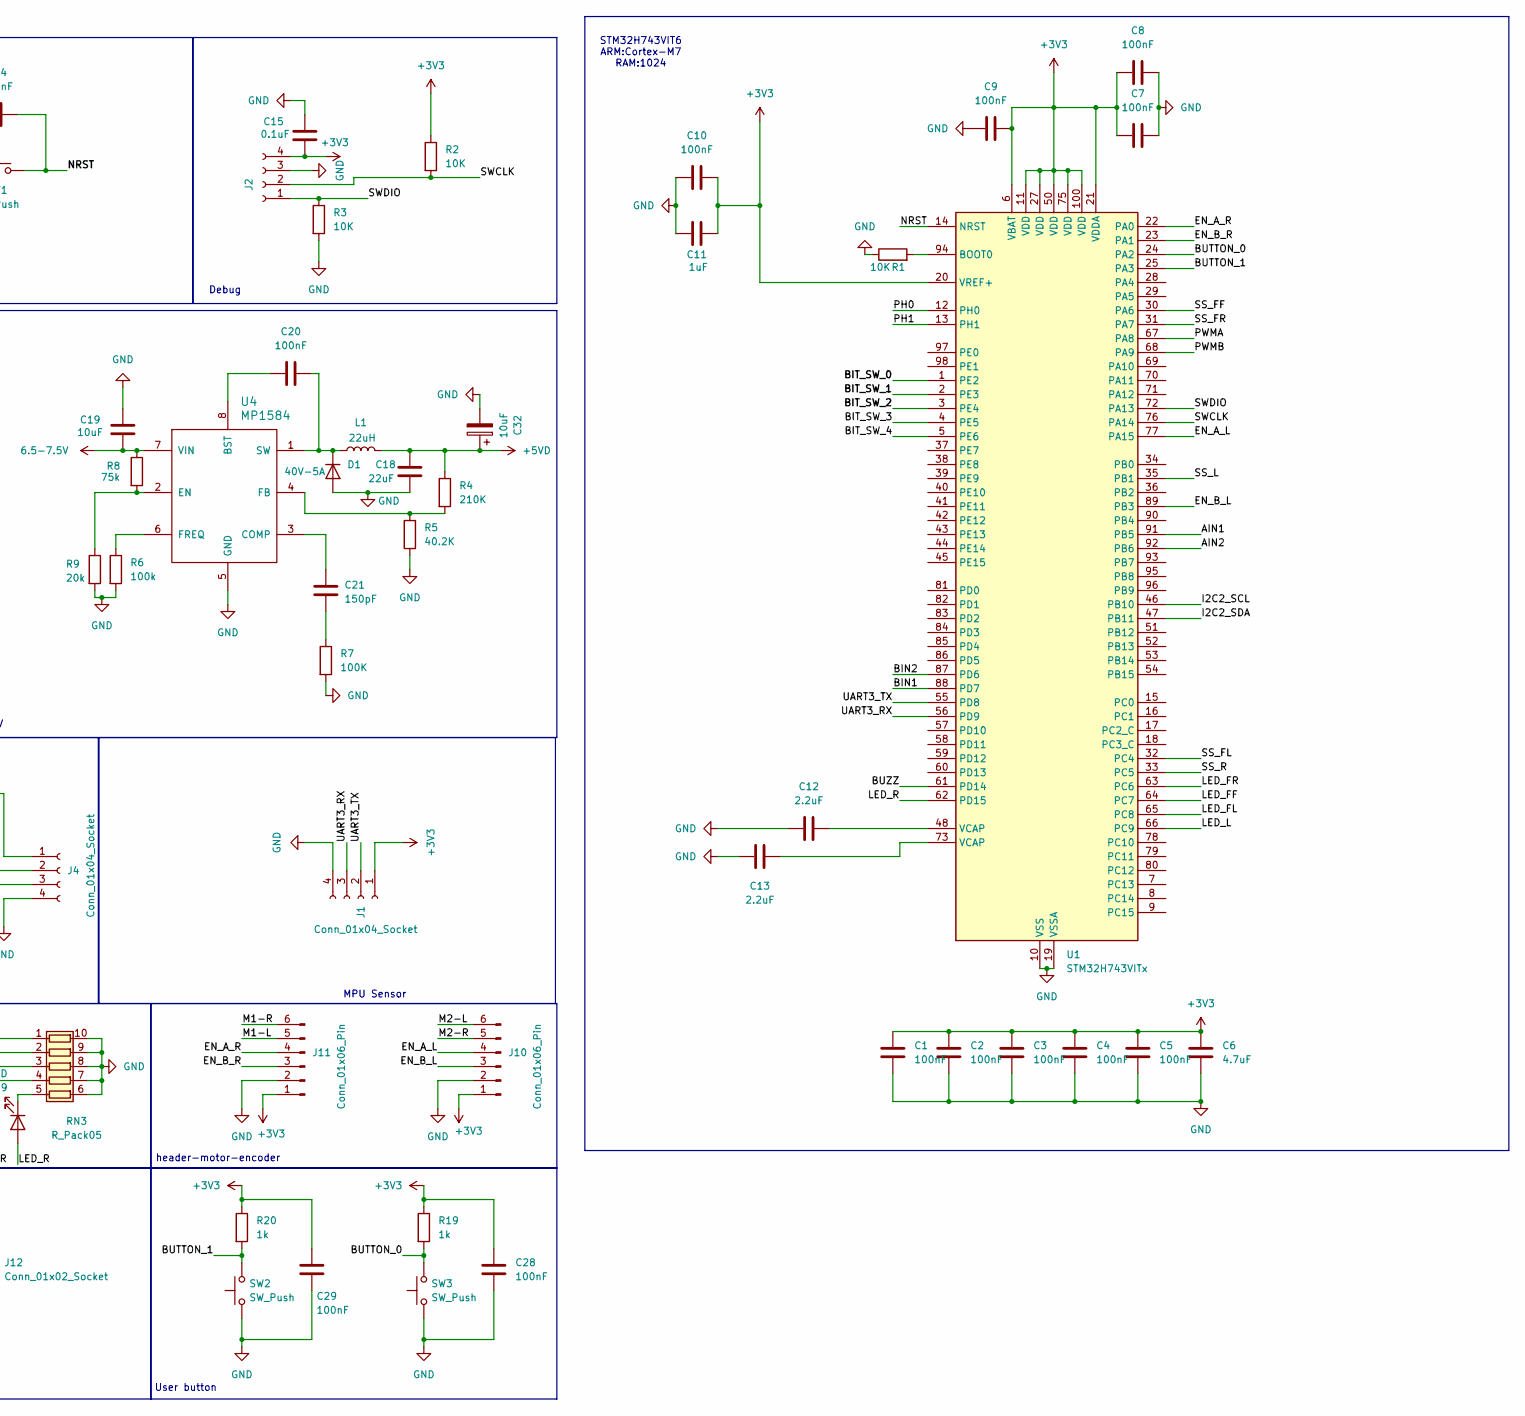
[picture p83: schematic schematic.kicad_sch, Micromouse24_2, part in row 1, column 2]

Parts:
C1, C2, C3, C4, C5, C7, C8, C9, C10, C14, C20, C22, C27, C28, C29: 100nF; C_0603_1608Metric
C6: 4.7uF; C_0603_1608Metric
C11: 1uF; C_0603_1608Metric
C12, C13: 2.2uF; C_0603_1608Metric
C15: 0.1uF; C_0603_1608Metric
C16, C17: 15pF; C_0603_1608Metric
C18: 22uF; C_0603_1608Metric
C19: 10uF; C_0603_1608Metric
C21: 150pF; C_0805_2012Metric
C23, C24, C30, C31: 22uF; CP_EIA-3216-10_Kemet-I
C25, C26, C32: 10uF; CP_EIA-3216-10_Kemet-I
D1: 40V-5A; D_SMA
D2, D3, D4, D5, D8, D9: LED; LED_0603_1608Metric
J1, J2, J4: Conn_01x04_Socket; JST 4
J5: Conn_01x07_Pin; PinHeader_1x07_P2.54mm_Vertical
J10, J11: Conn_01x06_Pin; JST 6
J12: Conn_01x02_Socket; jst
L1: 22uH; L_7.3x7.3_H4.5
LS1: CMT-8530S-SMT; CUI_CMT-8530S-SMT
Q1: S8550; SOT-23
R1, R2, R3: 10K; R_0603_1608Metric
R4: 210K; R_0603_1608Metric
R5: 40.2K; R_0805_2012Metric
R6: 100k; R_0603_1608Metric
R7: 100K; R_0603_1608Metric
R8: 75k; R_0805_2012Metric
R9: 20k; R_0805_2012Metric
R10, R11: 1K; R_0603_1608Metric
R17, R18: 4.7k; R_0603_1608Metric
R19, R20: 1k; R_0603_1608Metric
R21: 1.1R; R_0805_2012Metric
RN2, RN3: R_Pack05; R_Array_Convex_5x0603
SW1, SW2, SW3: SW_Push; SW_Tactile_SPST_NO_Straight_CK_PTS636Sx25SMTRLFS
SW4: SW_DIP_x05; SW_DIP_SPSTx05_Slide_KingTek_DSHP05TS_W7.62mm_P1.27mm
U1: STM32H743VITx; LQFP-100_14x14mm_P0.5mm
U2: AMS1117; SOT-223-3_TabPin2
U3: TB6612FNG_C_8_EL; SOP65P760X160-24N
U4: MP1584; SO-08POWER
U5: AMS1117-5.0; SOT-223-3_TabPin2
Y1: Crystal_GND23_Small; Crystal_SMD_3225-4Pin_3.2x2.5mm

Connections:
6.5-7.5V: C19.2, J12.1, R8.1, R21.1, U4.7 (VIN)
+3V3: C1.1, C2.1, C3.1, C4.1, C5.1, C6.1, C7.2, C8.2, C9.1, C10.1, C11.1, C15.1, C22.1, C24.1, C25.1, C28.1, C29.1, J1.1, J2.4, J4.1, J10.1, J11.1, Q1.1 (E), R2.1, R11.1, R17.1, R18.1, R19.1, R20.1, RN2.1 (R1.1), RN2.2 (R2.1), RN2.3 (R3.1), RN2.4 (R4.1), RN2.5 (R5.1), U1.6 (VBAT), U1.11 (VDD), U1.20 (VREF+), U1.21 (VDDA), U1.27 (VDD), U1.50 (VDD), U1.75 (VDD), U1.100 (VDD), U2.2 (VO), U3.19 (STBY), U3.20 (VCC); also elsewhere on the board
+5V: C23.1, C30.1, J5.7, U2.3 (VI), U5.2 (VO)
+5VD: C18.1, C26.1, C27.1, C32.1, L1.2, R4.1, U3.13 (VM2), U3.14 (VM3), U3.24 (VM1)
/AIN1: U1.91 (PB5), U3.21 (AIN1)
/AIN2: U1.92 (PB6), U3.22 (AIN2)
/BIN1: U1.88 (PD7), U3.17 (BIN1)
/BIN2: U1.87 (PD6), U3.16 (BIN2)
/BIT_SW_0: SW4.10, U1.1 (PE2)
/BIT_SW_1: SW4.9, U1.2 (PE3)
/BIT_SW_2: SW4.8, U1.3 (PE4)
/BIT_SW_3: SW4.7, U1.4 (PE5)
/BIT_SW_4: SW4.6, U1.5 (PE6)
/BUTTON_0: R19.2, SW3.2, U1.24 (PA2)
/BUTTON_1: R20.2, SW2.2, U1.25 (PA3)
/BUZZ: R10.2, U1.61 (PD14)
/EN_A_L: J10.4, U1.77 (PA15); also elsewhere on the board
/EN_A_R: J11.4, U1.22 (PA0); also elsewhere on the board
/EN_B_L: J10.3, U1.89 (PB3); also elsewhere on the board
/EN_B_R: J11.3, U1.23 (PA1); also elsewhere on the board
/I2C2_SCL: J4.3, R18.2, U1.46 (PB10); also elsewhere on the board
/I2C2_SDA: J4.2, R17.2, U1.47 (PB11); also elsewhere on the board
/LED_FF: D5.2 (A), U1.64 (PC7)
/LED_FL: D3.2 (A), U1.65 (PC8)
/LED_FR: D4.2 (A), U1.63 (PC6)
/LED_L: D8.2 (A), U1.66 (PC9)
/LED_R: D9.2 (A), U1.62 (PD15)
/M1-L: J11.5, U3.5 (AO2@1), U3.6 (AO2@2); also elsewhere on the board
/M1-R: J11.6, U3.1 (AO1@1), U3.2 (AO1@2); also elsewhere on the board
/M2-L: J10.6, U3.7 (BO2@1), U3.8 (BO2@2); also elsewhere on the board
/M2-R: J10.5, U3.11 (BO1@1), U3.12 (BO1@2); also elsewhere on the board
/NRST: C14.2, SW1.2, U1.14 (NRST); also elsewhere on the board
/PH0: C17.1, U1.12 (PH0), Y1.4
/PH1: C16.1, U1.13 (PH1), Y1.1
/PWMA: U1.67 (PA8), U3.23 (PWMA)
/PWMB: U1.68 (PA9), U3.15 (PWMB)
/SS_FF: J5.5, U1.30 (PA6)
/SS_FL: J5.3, U1.32 (PC4)
/SS_FR: J5.4, U1.31 (PA7)
/SS_L: J5.1, U1.35 (PB1)
/SS_R: J5.2, U1.33 (PC5)
/SWCLK: J2.2, R2.2, U1.76 (PA14); also elsewhere on the board
/SWDIO: J2.1, R3.1, U1.72 (PA13); also elsewhere on the board
/UART3_RX: J1.3, U1.56 (PD9)
/UART3_TX: J1.2, U1.55 (PD8)
GND: C1.2, C2.2, C3.2, C4.2, C5.2, C6.2, C7.1, C8.1, C9.2, C10.2, C11.2, C12.2, C13.2, C14.1, C15.2, C16.2, C17.2, C18.2, C19.1, C22.2, C23.2, C24.2, C25.2, C26.2, C27.2, C28.2, C29.2, C30.2, C31.2, C32.2, D1.2 (A), D2.1 (K), J1.4, J2.3, J4.4, J5.6, J10.2, J11.2, J12.2, LS1.N, R1.1, R3.2, R5.1, R6.2, R7.2, R9.2, RN3.6 (R5.2), RN3.7 (R4.2), RN3.8 (R3.2), RN3.9 (R2.2), RN3.10 (R1.2), SW1.1, SW2.1, SW3.1, U1.10 (VSS), U1.19 (VSSA), U1.26 (VSS), U1.49 (VSS), U1.74 (VSS), U1.99 (VSS), U2.1 (ADJ), U3.3 (PGND1@1), U3.4 (PGND1@2), U3.9 (PGND2@1), U3.10 (PGND2@2), U3.18 (GND), U4.5 (GND), U5.1 (GND), Y1.2, Y1.3; also elsewhere on the board
unnamed: C12.1, U1.48 (VCAP)
unnamed: C13.1, U1.73 (VCAP)
unnamed: C21.2, R7.1
unnamed: C20.2, D1.1 (K), L1.1, U4.1 (SW)
unnamed: D2.2 (A), R11.2
unnamed: D3.1 (K), RN3.2 (R2.1)
unnamed: D4.1 (K), RN3.4 (R4.1)
unnamed: D5.1 (K), RN3.3 (R3.1)
unnamed: D8.1 (K), RN3.1 (R1.1)
unnamed: D9.1 (K), RN3.5 (R5.1)
unnamed: Q1.2 (B), R10.1
unnamed 57: LS1.P, Q1.3 (C); also elsewhere on the board
unnamed: RN2.10 (R1.2), SW4.1
unnamed: RN2.9 (R2.2), SW4.2
unnamed: RN2.8 (R3.2), SW4.3
unnamed: RN2.7 (R4.2), SW4.4
unnamed: RN2.6 (R5.2), SW4.5
unnamed: R1.2, U1.94 (BOOT0)
unnamed: C20.1, U4.8 (BST)
unnamed: C21.1, U4.3 (COMP)
unnamed: R8.2, R9.1, U4.2 (EN)
unnamed: R4.2, R5.2, U4.4 (FB)
unnamed: R6.1, U4.6 (FREQ)
unnamed: C31.1, R21.2, U5.3 (VI)

Notes on the sheet:
MPU Sensor
User button
+3V3
Debug
STM32H743VIT6 ARM:Cortex-M7 RAM:1024
LED_Debug
Sensor-header
BUZZER
I2C
Driver
Button reset
header-motor-encoder
Crystal

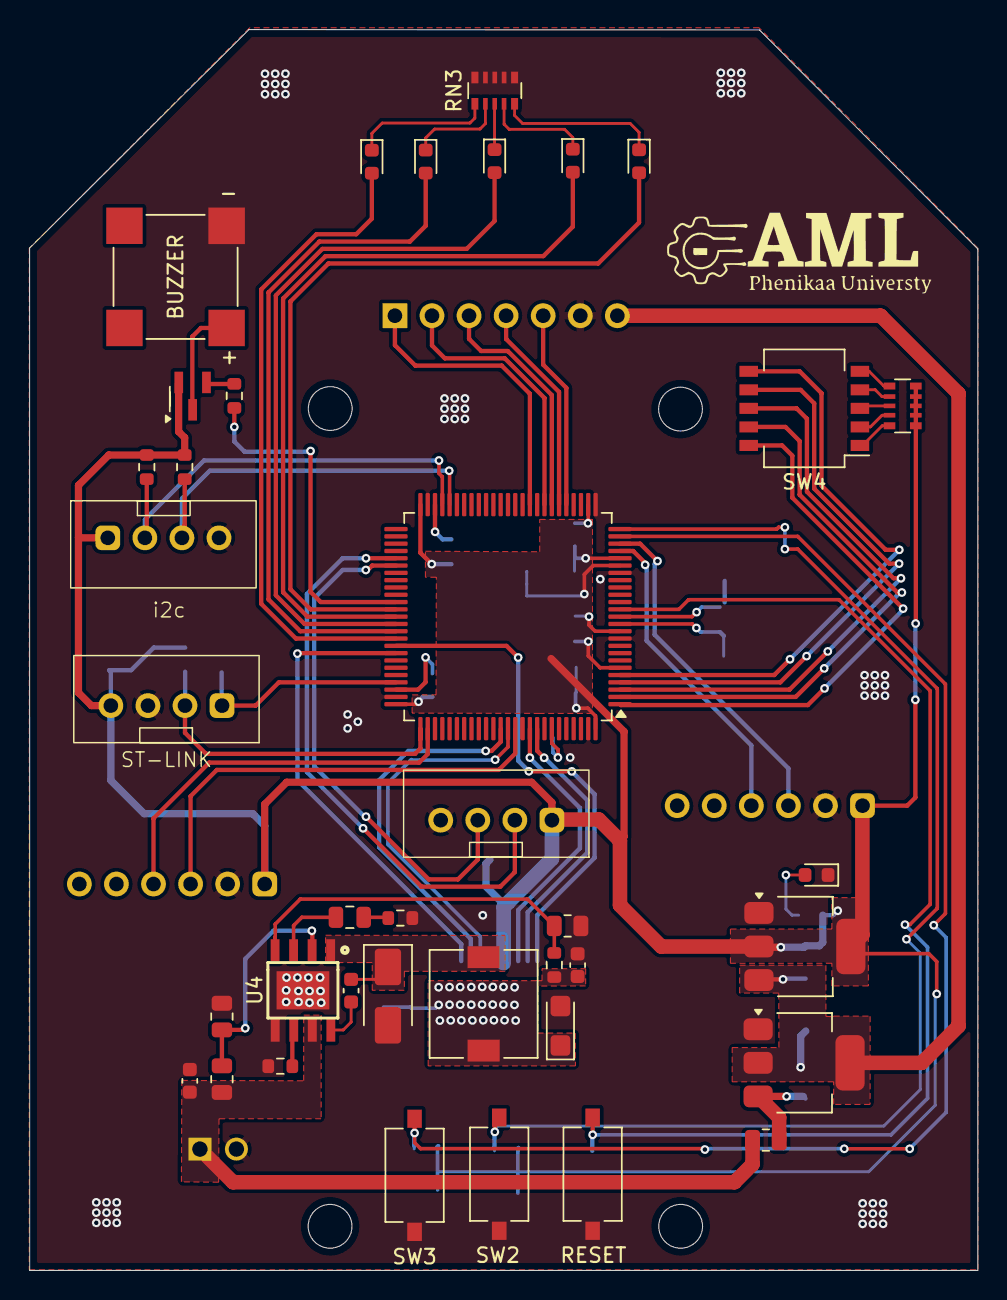
[picture p84: board schematic.kicad_pcb from above]

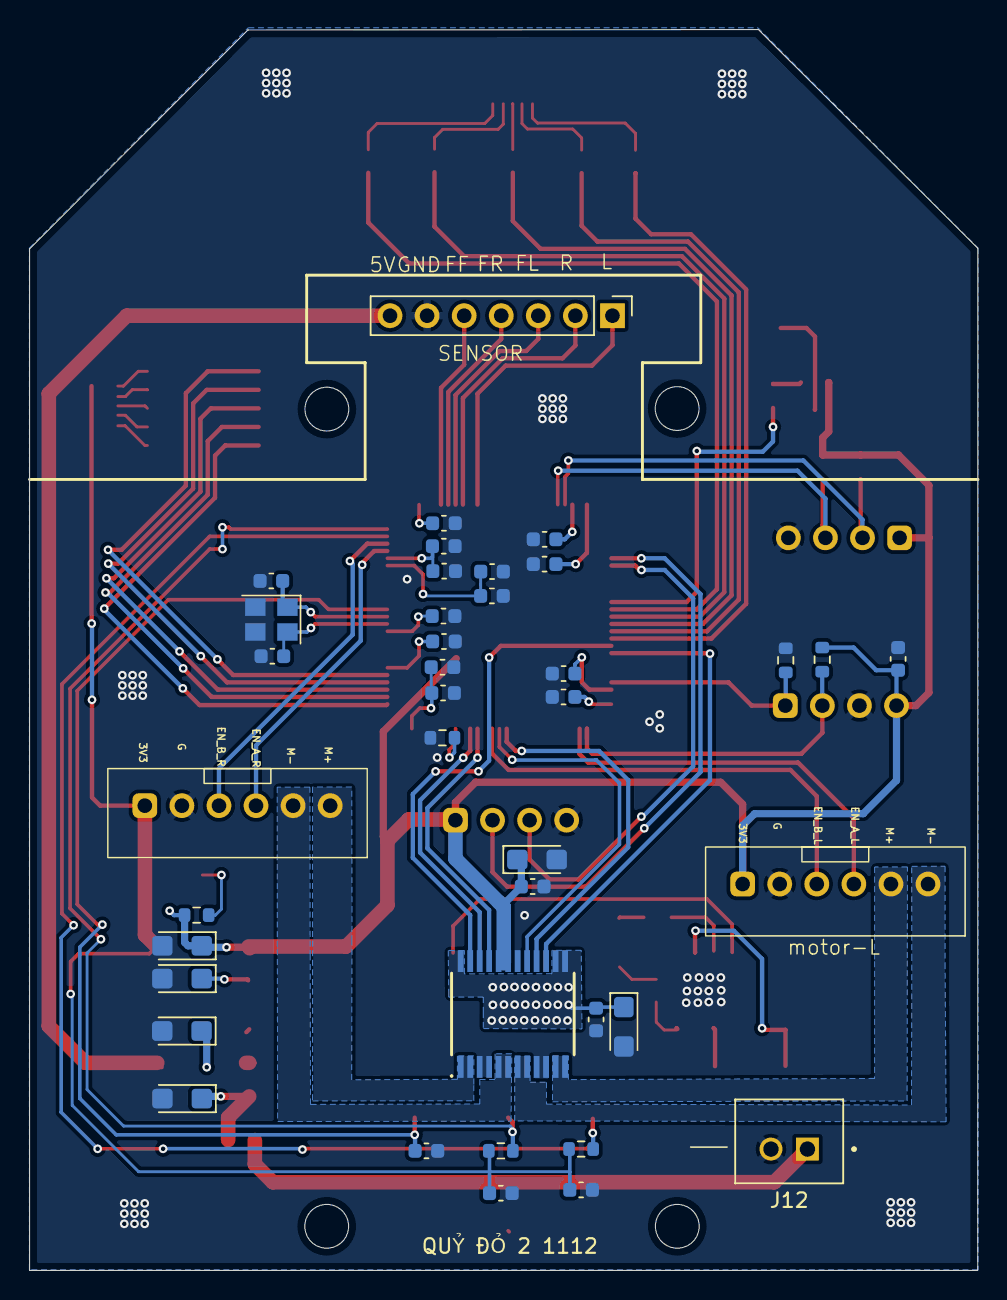
[picture p85: board schematic.kicad_pcb from below]

Board: 2 copper layers, 65.0 x 85.0 mm, 77 parts (39 on the bottom side), 70 nets.

Other parts of the board:
BUZZER: CMT-8530S-SMT; CUI_CMT-8530S-SMT
RESET: SW_Push; SW_Tactile_SPST_NO_Straight_CK_PTS636Sx25SMTRLFS
ST-LINK: Conn_01x04_Socket; JST 4
i2c: Conn_01x04_Socket; JST 4
moter-r: Conn_01x06_Pin; JST 6
motor-L: Conn_01x06_Pin; JST 6

Their connections:
+3V3: ST-LINK.4, i2c.1, moter-r.1, motor-L.1; also elsewhere on the board
/EN_A_L: motor-L.4; also elsewhere on the board
/EN_A_R: moter-r.4; also elsewhere on the board
/EN_B_L: motor-L.3; also elsewhere on the board
/EN_B_R: moter-r.3; also elsewhere on the board
/I2C2_SCL: i2c.3; also elsewhere on the board
/I2C2_SDA: i2c.2; also elsewhere on the board
/M1-L: moter-r.5; also elsewhere on the board
/M1-R: moter-r.6; also elsewhere on the board
/M2-L: motor-L.6; also elsewhere on the board
/M2-R: motor-L.5; also elsewhere on the board
/NRST: RESET.2; also elsewhere on the board
/SWCLK: ST-LINK.2; also elsewhere on the board
/SWDIO: ST-LINK.1; also elsewhere on the board
GND: BUZZER.N, RESET.1, ST-LINK.3, i2c.4, moter-r.2, motor-L.2; also elsewhere on the board
unnamed 57: BUZZER.P; also elsewhere on the board
