Oopsan204/AML_Micromouse_24_2/AML_Micromouse_24_2/Core/Src/main.c

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
/* Includes ------------------------------------------------------------------*/
#include "main.h"

/* USER CODE BEGIN Includes */
#include "SenSor.h"
#include "AML_GlobalVariable.h"
#include "AML_MPUSensor.h"
#include "AML_Buzzer.h"
#include "AML_LedDebug.h"
#include "AML_Switch.h"
#include "AML_MotorControl.h"
#include "AML_Encoder.h"
#include "AML_PID.h"
#include "solver.h"

/* USER CODE END Includes */

ADC_HandleTypeDef hadc1;

I2C_HandleTypeDef hi2c2;

RAMECC_HandleTypeDef hramecc1_m1;
RAMECC_HandleTypeDef hramecc1_m2;
RAMECC_HandleTypeDef hramecc1_m3;
RAMECC_HandleTypeDef hramecc1_m4;
RAMECC_HandleTypeDef hramecc1_m5;
RAMECC_HandleTypeDef hramecc2_m1;
RAMECC_HandleTypeDef hramecc2_m2;
RAMECC_HandleTypeDef hramecc2_m3;
RAMECC_HandleTypeDef hramecc2_m4;
RAMECC_HandleTypeDef hramecc2_m5;
RAMECC_HandleTypeDef hramecc3_m1;
RAMECC_HandleTypeDef hramecc3_m2;

TIM_HandleTypeDef htim1;
TIM_HandleTypeDef htim2;
TIM_HandleTypeDef htim4;
TIM_HandleTypeDef htim5;
TIM_HandleTypeDef htim7;

UART_HandleTypeDef huart3;
DMA_HandleTypeDef hdma_usart3_rx;

/* USER CODE BEGIN PV */
double CurrentAngle = 0;
uint32_t frequency_test = 1000;
uint32_t leftEncoder = 0;
uint32_t rightEncoder = 0;
double test = 0;
uint32_t pwm = 50;
uint32_t ADCrawbuffer[5];
int32_t EncoderGetRightValue = 0;
int32_t EncoderGetLeftValue = 0;
uint32_t debug[100];
/* USER CODE END PV */

void SystemClock_Config(void);
static void MPU_Config(void);
static void MX_GPIO_Init(void);
static void MX_DMA_Init(void);
static void MX_RAMECC_Init(void);
static void MX_ADC1_Init(void);
static void MX_TIM1_Init(void);
static void MX_TIM2_Init(void);
static void MX_TIM5_Init(void);
static void MX_USART3_UART_Init(void);
static void MX_I2C2_Init(void);
static void MX_TIM4_Init(void);
static void MX_TIM7_Init(void);
/**
  * @brief  The application entry point.
  * @retval int
  */
int main(void)
{

  /* MPU Configuration--------------------------------------------------------*/
  MPU_Config();

  /* MCU Configuration--------------------------------------------------------*/

  /* Reset of all peripherals, Initializes the Flash interface and the Systick. */
  HAL_Init();

  /* Configure the system clock */
  SystemClock_Config();

  /* USER CODE BEGIN SysInit */

  // AML_Buzzer_TurnOff();
  /* USER CODE END SysInit */

  /* Initialize all configured peripherals */
  MX_GPIO_Init();
  MX_DMA_Init();
  MX_RAMECC_Init();
  MX_ADC1_Init();
  MX_TIM1_Init();
  MX_TIM2_Init();
  MX_TIM5_Init();
  MX_USART3_UART_Init();
  MX_I2C2_Init();
  MX_TIM4_Init();
  MX_TIM7_Init();
  /* USER CODE BEGIN 2 */
  AML_MPUSensor_ResetAngle();
  AML_MPUSensor_Setup();
  AML_Encoder_Setup();
  AML_IRSensor_Setup();
  AML_MotorControl_Setup();
  AML_Buzzer_TurnOn();
  // AML_Buzzer_Beep();
  AML_LedDebug_SetAllLED(GPIO_PIN_SET);

  /* USER CODE END 2 */

  /* Infinite loop */
  /* USER CODE BEGIN WHILE */
  while (1)
  {
    /* USER CODE END WHILE */

    /* USER CODE BEGIN 3 */

    CurrentAngle = AML_MPUSensor_GetAngle();
    test = AML_IRSensor_GetDistance(0);
    AML_LedDebug_ToggleAllLED();
    // AML_MotorControl_Move(pwm, -50);
    EncoderGetLeftValue = AML_Encoder_GetLeftValue();
    EncoderGetRightValue = AML_Encoder_GetRightValue();
    
    if (AML_Read_Button(0)==1)
    {
      AML_MotorControl_GoStraghtWithMPU(0);
      AML_Buzzer_Beep();
    }
    
    else if (AML_Read_Button(1) == 1)
    {
      AML_Buzzer_TurnOff();
      AML_MotorControl_Stop();
    }
   

    AML_ReadAll_BitSwitch();
    AML_ReadAll_Button();
    HAL_Delay(40);
  }
  /* USER CODE END 3 */
}

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
 /* MPU Configuration */

void MPU_Config(void)
{
  MPU_Region_InitTypeDef MPU_InitStruct = {0};

  /* Disables the MPU */
  HAL_MPU_Disable();

  /** Initializes and configures the Region and the memory to be protected
  */
  MPU_InitStruct.Enable = MPU_REGION_ENABLE;
  MPU_InitStruct.Number = MPU_REGION_NUMBER0;
  MPU_InitStruct.BaseAddress = 0x0;
  MPU_InitStruct.Size = MPU_REGION_SIZE_4GB;
  MPU_InitStruct.SubRegionDisable = 0x87;
  MPU_InitStruct.TypeExtField = MPU_TEX_LEVEL0;
  MPU_InitStruct.AccessPermission = MPU_REGION_NO_ACCESS;
  MPU_InitStruct.DisableExec = MPU_INSTRUCTION_ACCESS_DISABLE;
  MPU_InitStruct.IsShareable = MPU_ACCESS_SHAREABLE;
  MPU_InitStruct.IsCacheable = MPU_ACCESS_NOT_CACHEABLE;
  MPU_InitStruct.IsBufferable = MPU_ACCESS_NOT_BUFFERABLE;

  HAL_MPU_ConfigRegion(&MPU_InitStruct);
  /* Enables the MPU */
  HAL_MPU_Enable(MPU_PRIVILEGED_DEFAULT);

}

/**
  * @brief  This function is executed in case of error occurrence.
  * @retval None
  */
void Error_Handler(void)
{
  /* USER CODE BEGIN Error_Handler_Debug */
  /* User can add his own implementation to report the HAL error return state */
  __disable_irq();
  while (1)
  {
  }
  /* USER CODE END Error_Handler_Debug */
}

#ifdef  USE_FULL_ASSERT
/**
  * @brief  Reports the name of the source file and the source line number
  *         where the assert_param error has occurred.
  * @param  file: pointer to the source file name
  * @param  line: assert_param error line source number
  * @retval None
  */
void assert_failed(uint8_t *file, uint32_t line)
{
  /* USER CODE BEGIN 6 */
  /* User can add his own implementation to report the file name and line number,
     ex: printf("Wrong parameters value: file %s on line %d\r\n", file, line) */
  /* USER CODE END 6 */
}
#endif /* USE_FULL_ASSERT */
