Oopsan204/AML_Micromouse_24_2/AML_Micromouse_24_2/AML_Micromouse_24_2.ioc

Mcu.UserName=STM32H743VITx
PA0.GPIO_Label=EN_A_R
PA0.Signal=S_TIM5_CH1
PA1.GPIO_Label=EN_B_L
PA1.Signal=S_TIM5_CH2
PA2.GPIO_Label=BUTTON_0
PA2.Signal=GPIO_Input
PA3.GPIO_Label=BUTTON_1
PA3.Signal=GPIO_Input
PA6.GPIO_Label=SS_FF
PA6.Signal=ADCx_INP3
PA7.GPIO_Label=SS_FR
PA7.Signal=ADCx_INP7
PA8.GPIO_Label=PWMA
PA8.Signal=S_TIM1_CH1
PA9.GPIO_Label=PWMB
PA9.Signal=S_TIM1_CH2
PB1.GPIO_Label=SS_L
PB1.Signal=ADCx_INP5
PB10.Signal=I2C2_SCL
PB11.Signal=I2C2_SDA
PB5.GPIO_Label=AIN1
PB5.Signal=GPIO_Output
PB6.GPIO_Label=AIN2
PB6.Signal=GPIO_Output
PC4.GPIO_Label=SS_FL
PC4.Signal=ADCx_INP4
PC5.GPIO_Label=SS_R
PC5.Signal=ADCx_INP8
PC6.GPIO_Label=LED_1
PC6.Signal=GPIO_Output
PC7.GPIO_Label=LED_2
PC7.Signal=GPIO_Output
PC8.GPIO_Label=LED_3
PC8.Signal=GPIO_Output
PC9.GPIO_Label=LED_4
PC9.Signal=GPIO_Output
PD14.GPIO_Label=buzzer
PD14.Signal=S_TIM4_CH3
PD15.GPIO_Label=LED_0
PD15.Signal=GPIO_Output
PD6.GPIO_Label=BIN2
PD6.Signal=GPIO_Output
PD7.GPIO_Label=BIN1
PD7.Signal=GPIO_Output
PD8.Signal=USART3_TX
PD9.Signal=USART3_RX
PE2.GPIO_Label=BIT_SW_0
PE2.Signal=GPIO_Input
PE3.GPIO_Label=BIT_SW_1
PE3.Signal=GPIO_Input
PE4.GPIO_Label=BIT_SW_2
PE4.Signal=GPIO_Input
PE5.GPIO_Label=BIT_SW_3
PE5.Signal=GPIO_Input
PE6.GPIO_Label=BIT_SW_4
PE6.Signal=GPIO_Input
