Oopsan204/AML_Micromouse_24_2/AML_Micromouse_24_2/Core/Inc/SenSor.h

#ifndef SenSor_H
#define SenSor_H

#include "stm32h7xx_hal.h"
#include "string.h"
#include <AML_GlobalVariable.h>
#include "math.h"
#include "main.h"

void AML_IRSensor_Setup(void);
double AML_IRSensor_GetDistance(uint8_t sensor);
uint8_t AML_IRSensor_IsFrontWall(void);
uint8_t AML_IRSensor_IsRightWall(void);
uint8_t AML_IRSensor_IsLeftWall(void);

#endif
