Oopsan204/AML_Micromouse_24_2/AML_Micromouse_24_2/Core/Inc/AML_Switch.h

#ifndef AML_SWITCH_H
#define AML_SWITCH_H

#include "stm32h7xx_hal.h"
#include "main.h"
#include "AML_GlobalVariable.h"

void AML_ReadAll_BitSwitch(void);
uint8_t AML_Read_BitSwitch(uint8_t index);

void AML_ReadAll_Button(void);
uint8_t AML_Read_Button(uint8_t index);

void HAL_GPIO_EXTI_Callback(uint16_t GPIO_Pin);

#endif
