Oopsan204/AML_Micromouse_24_2/(commit log)

2024-08-31 vẽ xong phần cơ bản
    [schematic.kicad_pcb, schematic.kicad_sch]
2024-09-05 thêm phần driver tb66, ve phần nguồn 5v
    [TB6612FNG,C,8,EL.STEP, TB6612FNG_C_8_EL.step, schematic.kicad_pcb, schematic.kicad_sch]
2024-09-06 xong phần nguồn
    [schematic.csv, schematic.kicad_pcb, schematic.kicad_sch]
2024-09-07 vẽ đủ đò ăn chơi chưa duyệt
    [schematic.csv, schematic.kicad_pcb, schematic.kicad_sch]
2024-09-07 thếu nút nhấn
    [schematic.kicad_pcb, schematic.kicad_sch]
2024-09-13 trc khi xoá ve lai
    [schematic.kicad_pcb, schematic.kicad_sch]
2024-10-19 gần hoàn thiện pcb
    [schematic.dsn, schematic.kicad_pcb, schematic.kicad_sch]
2024-10-20 cho doi xi va
    [BM06B-SRSS-TB.STEP, CUI_DEVICES_CMT-8504-100-SMT-TR.step, JST - XH - Thru (V) - 4Pin - 2.54mm.stp, schematic.kicad_pcb, schematic.kicad_sch]
2024-10-22 khá ổn chờ chốt
    [INDUCTOR_73x73h5.step, schematic.csv, schematic.kicad_pcb, schematic.kicad_sch]
2024-10-23 thêm file thiet ke va da chinh sua nhung chua chot
    [22082024 micromouse T2.SLDASM, JST - XH - Thru (V) - 7Pin - 2.54mm.stp, Lop banh xe.SLDPRT, Mam banh xe.SLDPRT, N20 DC MOTOR.SLDPRT, SHARP GP2Y0A51SK0F.step, TRUC 2MM.SLDPRT, banh rang 16T truc 2 m0.5.STEP]
2024-10-24 đã đặt mạch
    [GSC8530YA-16R2700.STEP, Inductor_7x7x2.5.STEP, JST - XH - Thru (V) - 6Pin - 2.54mm.stp, SO-8_narrow_simple.step, bom.csv, designators.csv, positions.csv, schematic.csv]
2024-10-28 thư viện đọc sensor analog
    [bom.csv, bom.xlsx, schematic.kicad_pcb]
2024-11-05 test pcb hoạt động adc+mpu+bitsw+button
    [bom.xlsx, freerouting.dsn, schematic.step.SLDASM, temp-freerouting.dsn]
2024-11-07 đổi sang cmake
    [BM06B-SRSS-TB.STEP, CUI_DEVICES_CMT-8504-100-SMT-TR.step, GSC8530YA-16R2700.STEP, INDUCTOR_73x73h5.step, Inductor_7x7x2.5.STEP, JST - XH - Thru (R) - 10Pin - 2.54mm.stp, JST - XH - Thru (R) - 11Pin - 2.54mm.stp, JST - XH - Thru (R) - 12Pin - 2.54mm.stp]
2024-11-29 đã build được bằng cmake và đang viết hàm bám trường rẽ trái rẽ phải
