Oopsan204/AML_Micromouse_24_2/(notices)

Notices in the files:
AML_Micromouse_24_2/Core/Inc/main.h:
Copyright (c) 2024 STMicroelectronics.
All rights reserved.
This software is licensed under terms that can be found in the LICENSE file
